LifeOnAFarm/RaveLearnDJTable/hardware/3d-prints/Switch Cover.STL

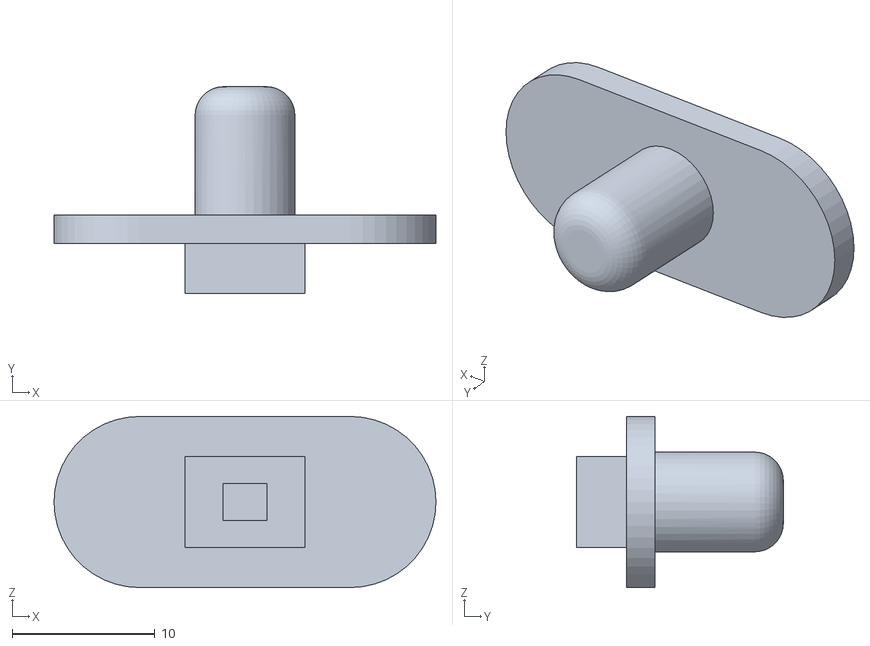
[picture p1: CAD file, 2026-10-12]
hardware/3d-prints/Switch Cover.STL
26.8 x 14.5 x 12.0
