LifeOnAFarm/RaveLearnDJTable/hardware/3d-prints/AS5600 Mount.STL

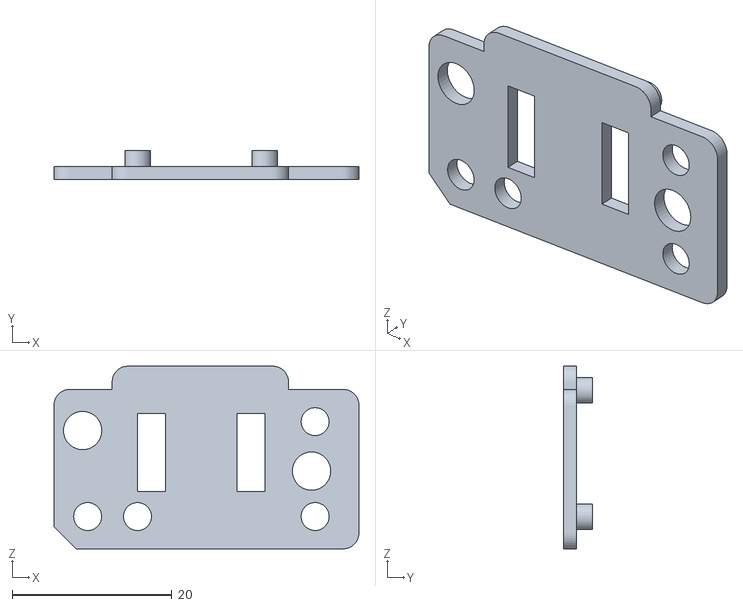
[picture p2: CAD file, 2026-10-10]
hardware/3d-prints/AS5600 Mount.STL
38.2 x 3.60 x 22.9
