LifeOnAFarm/RaveLearnDJTable/hardware/3d-prints/Mode Button.STL

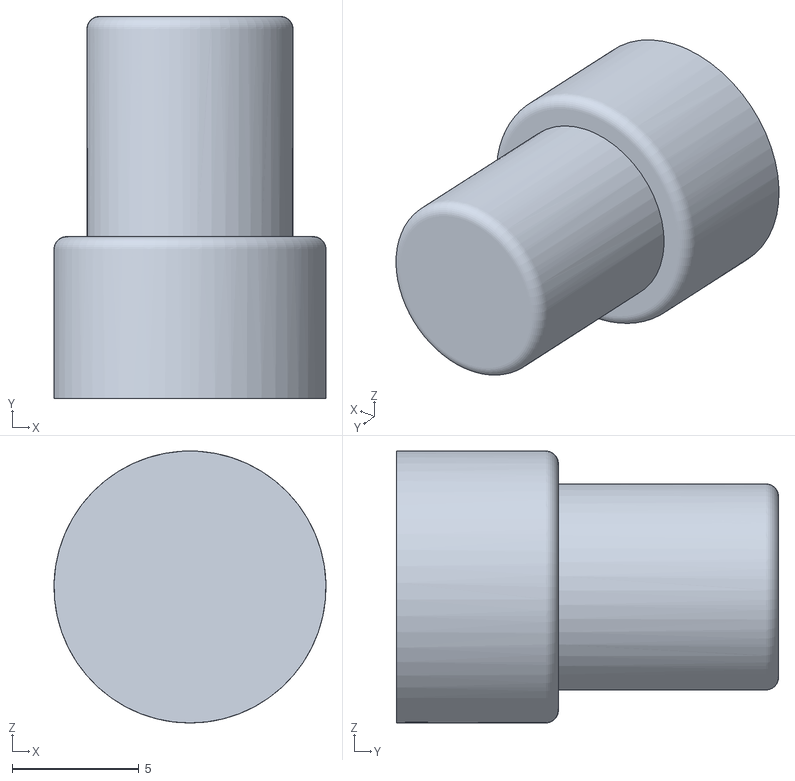
[picture p3: CAD file, 2026-10-10]
hardware/3d-prints/Mode Button.STL
10.8 x 15.1 x 10.8
