LifeOnAFarm/RaveLearnDJTable/hardware/3d-prints/Speaker Holder.STL

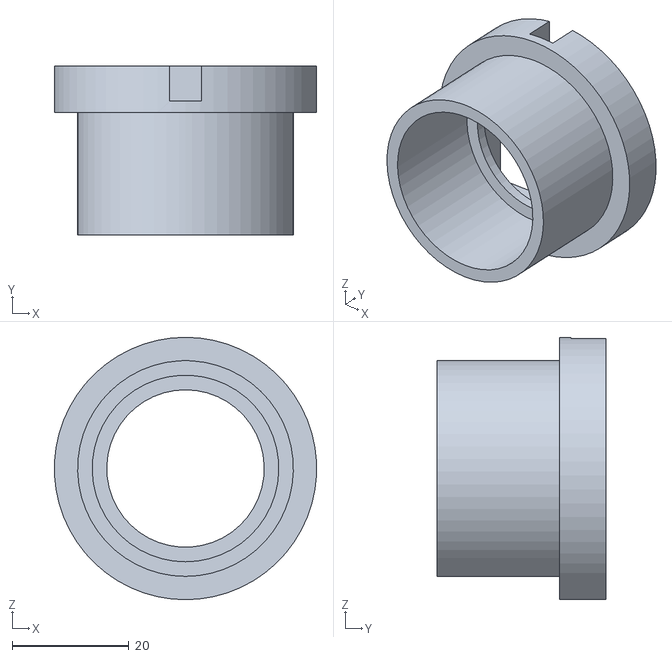
[picture p4: CAD file, 2026-10-10]
hardware/3d-prints/Speaker Holder.STL
44.9 x 29.0 x 45.0
