LifeOnAFarm/RaveLearnDJTable/hardware/3d-prints/Platter Mount.STL

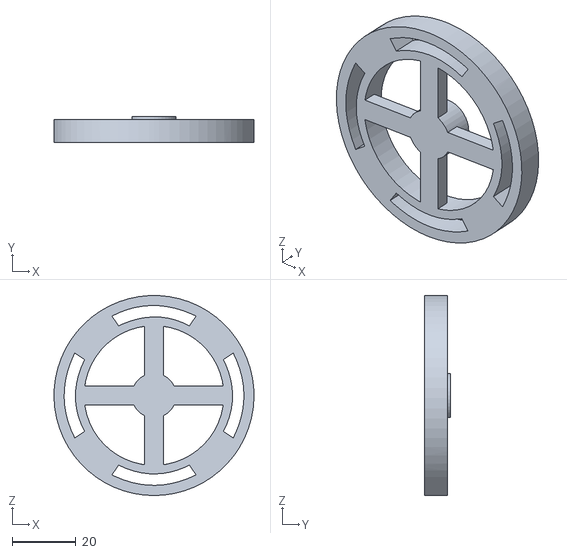
[picture p5: CAD file, 2026-10-10]
hardware/3d-prints/Platter Mount.STL
63.0 x 8.30 x 63.0
