LifeOnAFarm/RaveLearnDJTable/hardware/DJTable-schematic.pdf

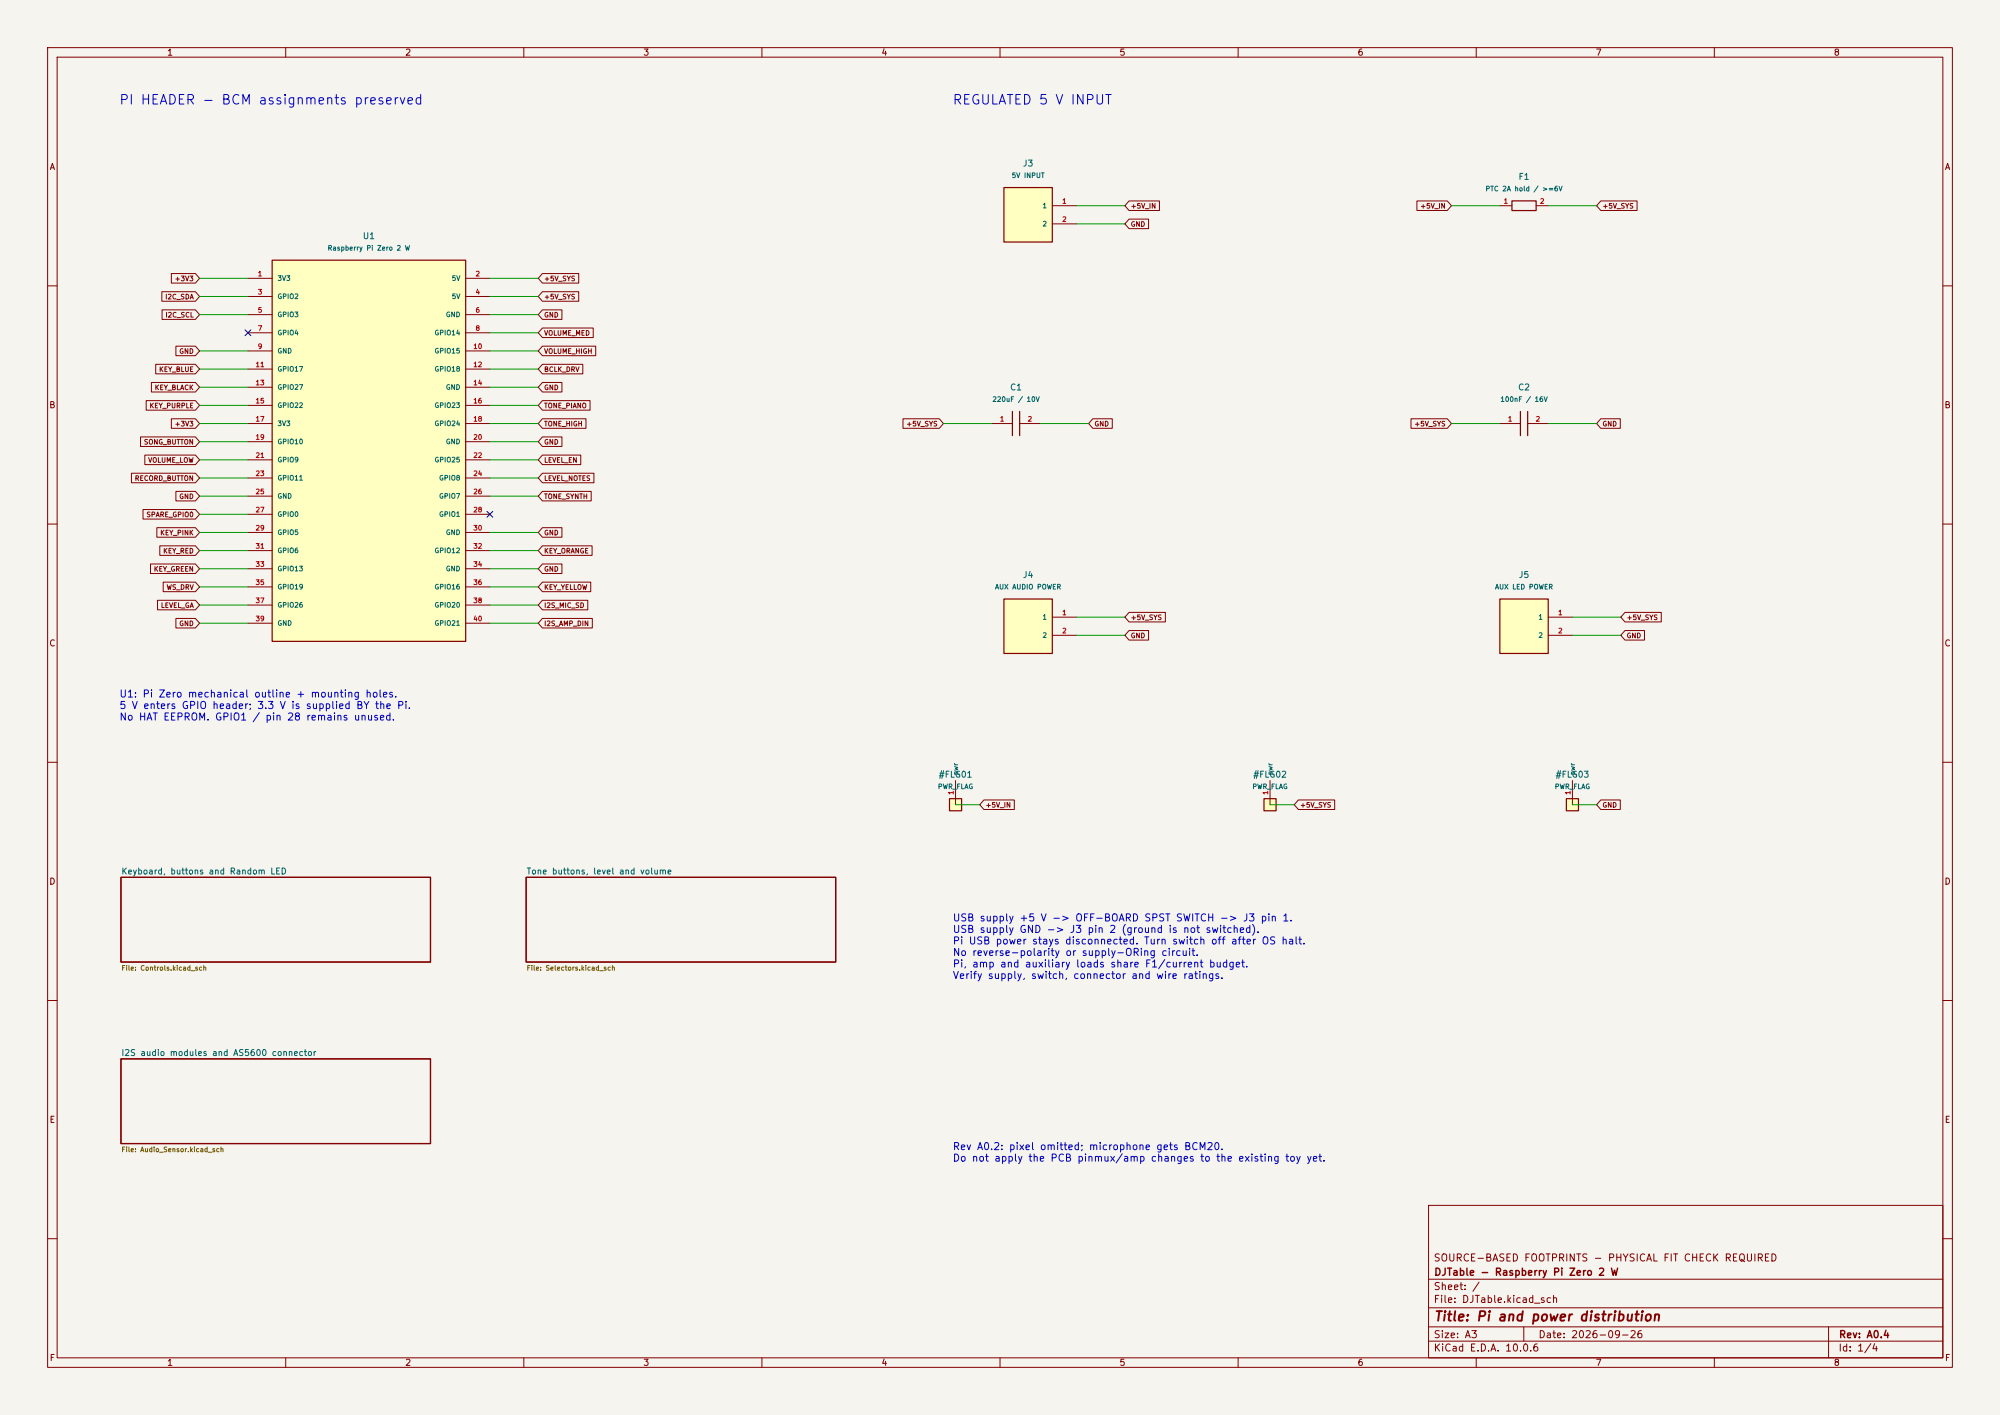
[picture p6: page 1]

PI HEADER - BCM assignments preserved

AUX LED POWER pwr 1 #FLG02

U1: Pi Zero mechanical outline + mounting holes.
5 V enters GPIO header; 3.3 V is supplied BY the Pi.
No HAT EEPROM. GPIO1 / pin 28 remains unused.

File: Selectors.kicad_sch Keyboard, buttons and Random LED

Tone buttons, level and volume

USB supply +5 V -> OFF-BOARD SPST SWITCH -> J3 pin 1.
USB supply GND -> J3 pin 2 (ground is not switched).
Pi USB power stays disconnected. Turn switch off after OS halt.
No reverse-polarity or supply-ORing circuit.
Pi, amp and auxiliary loads share F1/current budget.
Verify supply, switch, connector and wire ratings.

I2S audio modules and AS5600 connector File: Audio_Sensor.kicad_sch

Rev A0.2: pixel omitted; microphone gets BCM20.
Do not apply the PCB pinmux/amp changes to the existing toy yet.

SOURCE-BASED FOOTPRINTS - PHYSICAL FIT CHECK REQUIRED
DJTable - Raspberry Pi Zero 2 W
Sheet: /
File: DJTable.kicad_sch
Title: Pi and power distribution

Size: A3 | Rev: A0.4 | F Date: 2026-09-26
KiCad E.D.A. 10.0.6 | Id: 1/4

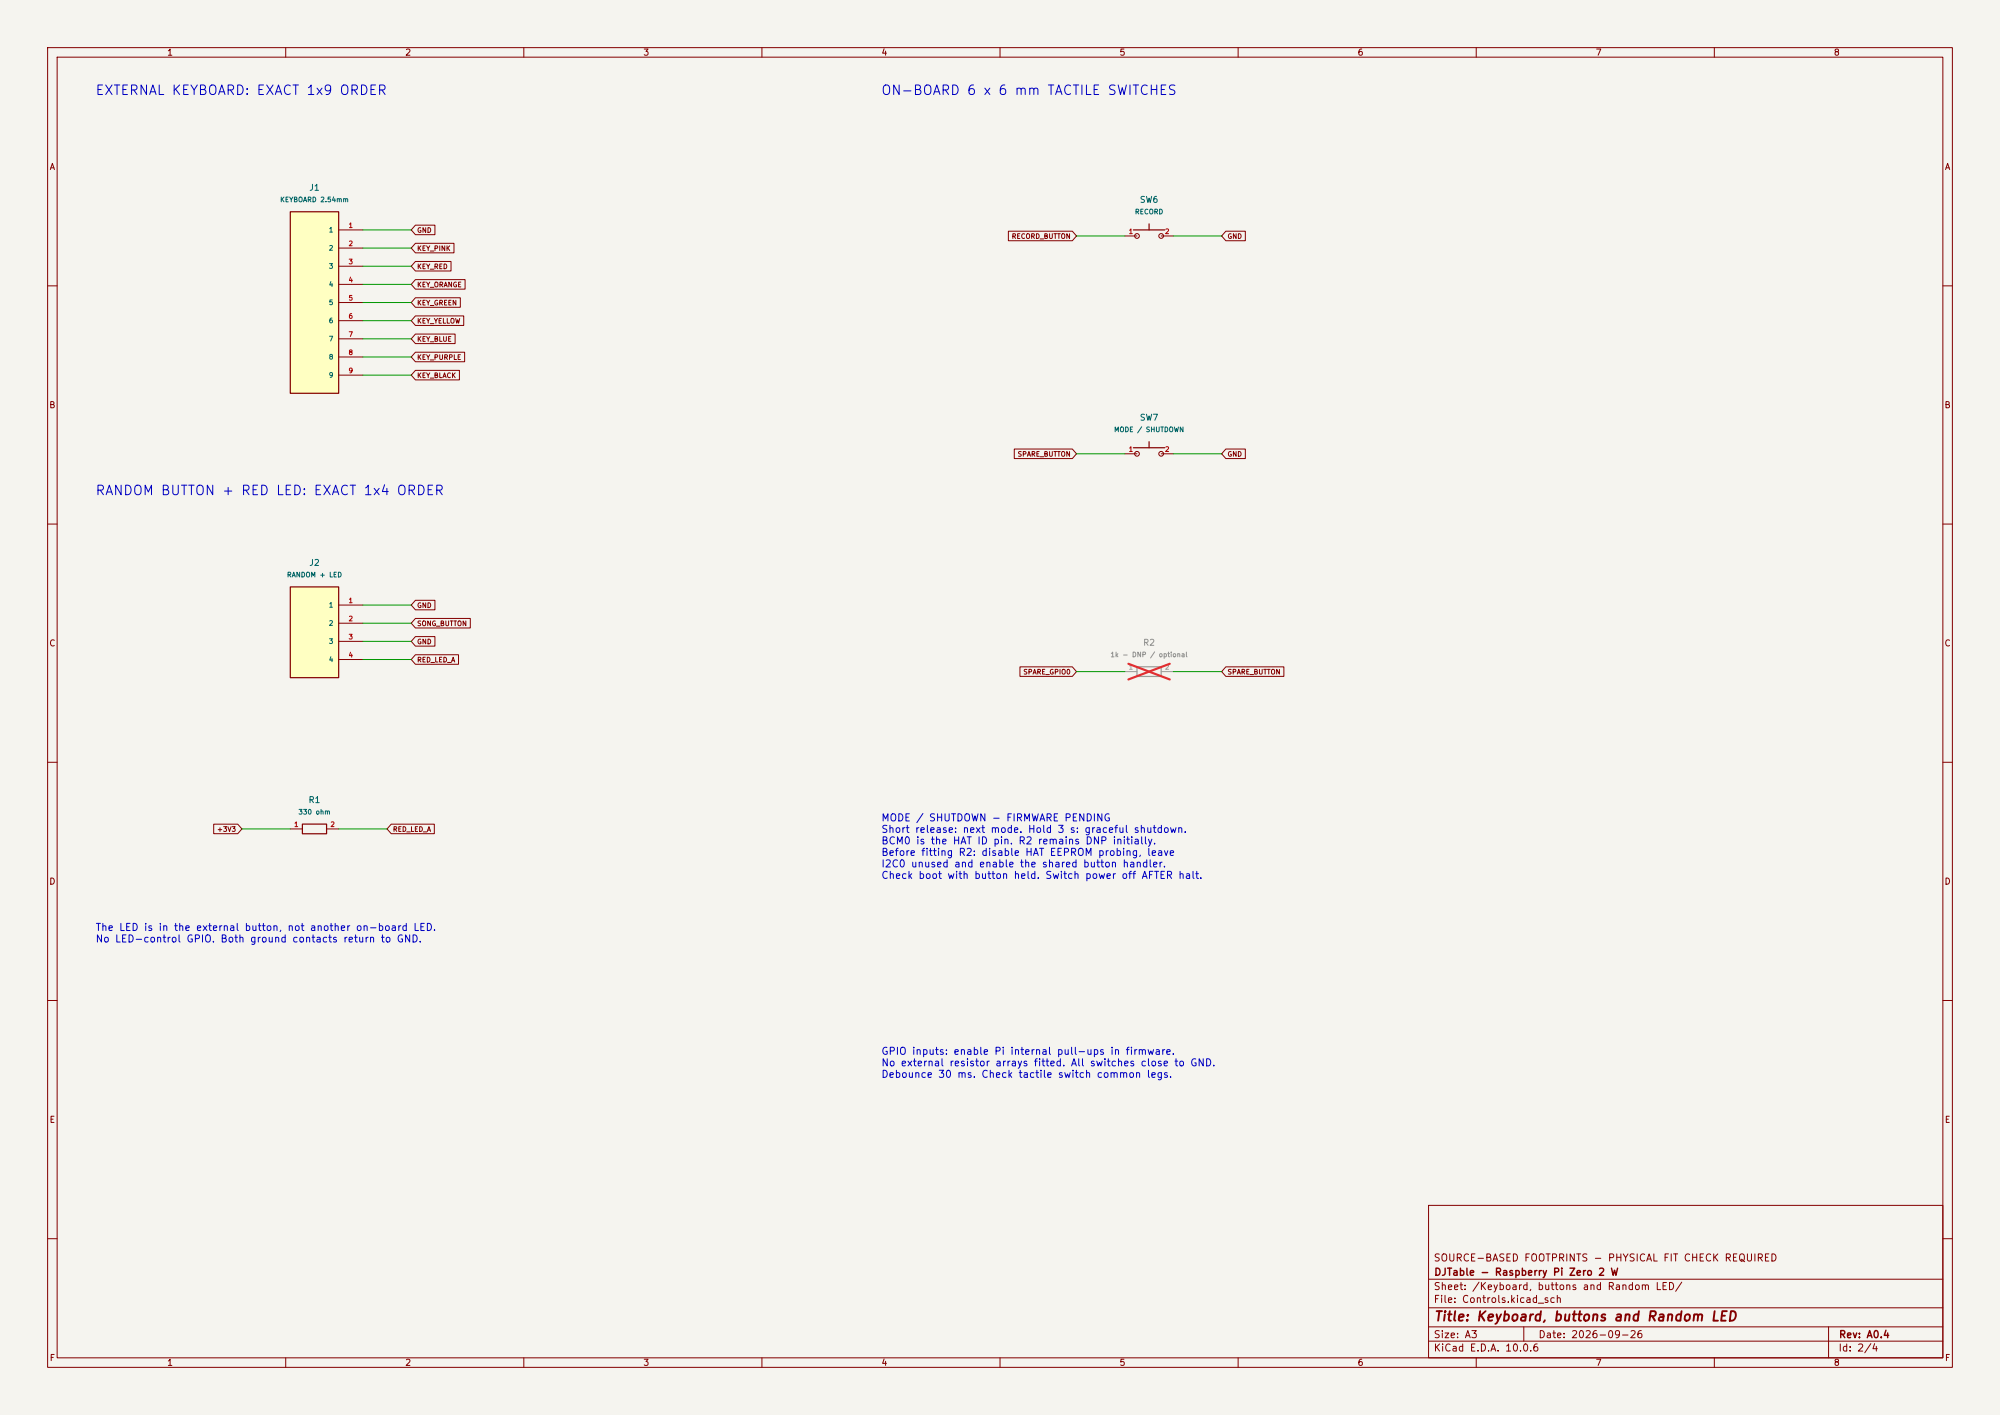
[picture p7: page 2]

EXTERNAL KEYBOARD: EXACT 1x9 ORDER

ON-BOARD 6 x 6 mm TACTILE SWITCHES

KEY_BLACK RANDOM BUTTON + RED LED: EXACT 1x4 ORDER

MODE / SHUTDOWN - FIRMWARE PENDING
Short release: next mode. Hold 3 s: graceful shutdown.
BCM0 is the HAT ID pin. R2 remains DNP initially.
Before fitting R2: disable HAT EEPROM probing, leave
I2C0 unused and enable the shared button handler.
Check boot with button held. Switch power off AFTER halt.

The LED is in the external button, not another on-board LED.
No LED-control GPIO. Both ground contacts return to GND.

GPIO inputs: enable Pi internal pull-ups in firmware.
No external resistor arrays fitted. All switches close to GND.
Debounce 30 ms. Check tactile switch common legs.

SOURCE-BASED FOOTPRINTS - PHYSICAL FIT CHECK REQUIRED
DJTable - Raspberry Pi Zero 2 W
Sheet: /Keyboard, buttons and Random LED/
File: Controls.kicad_sch
Title: Keyboard, buttons and Random LED

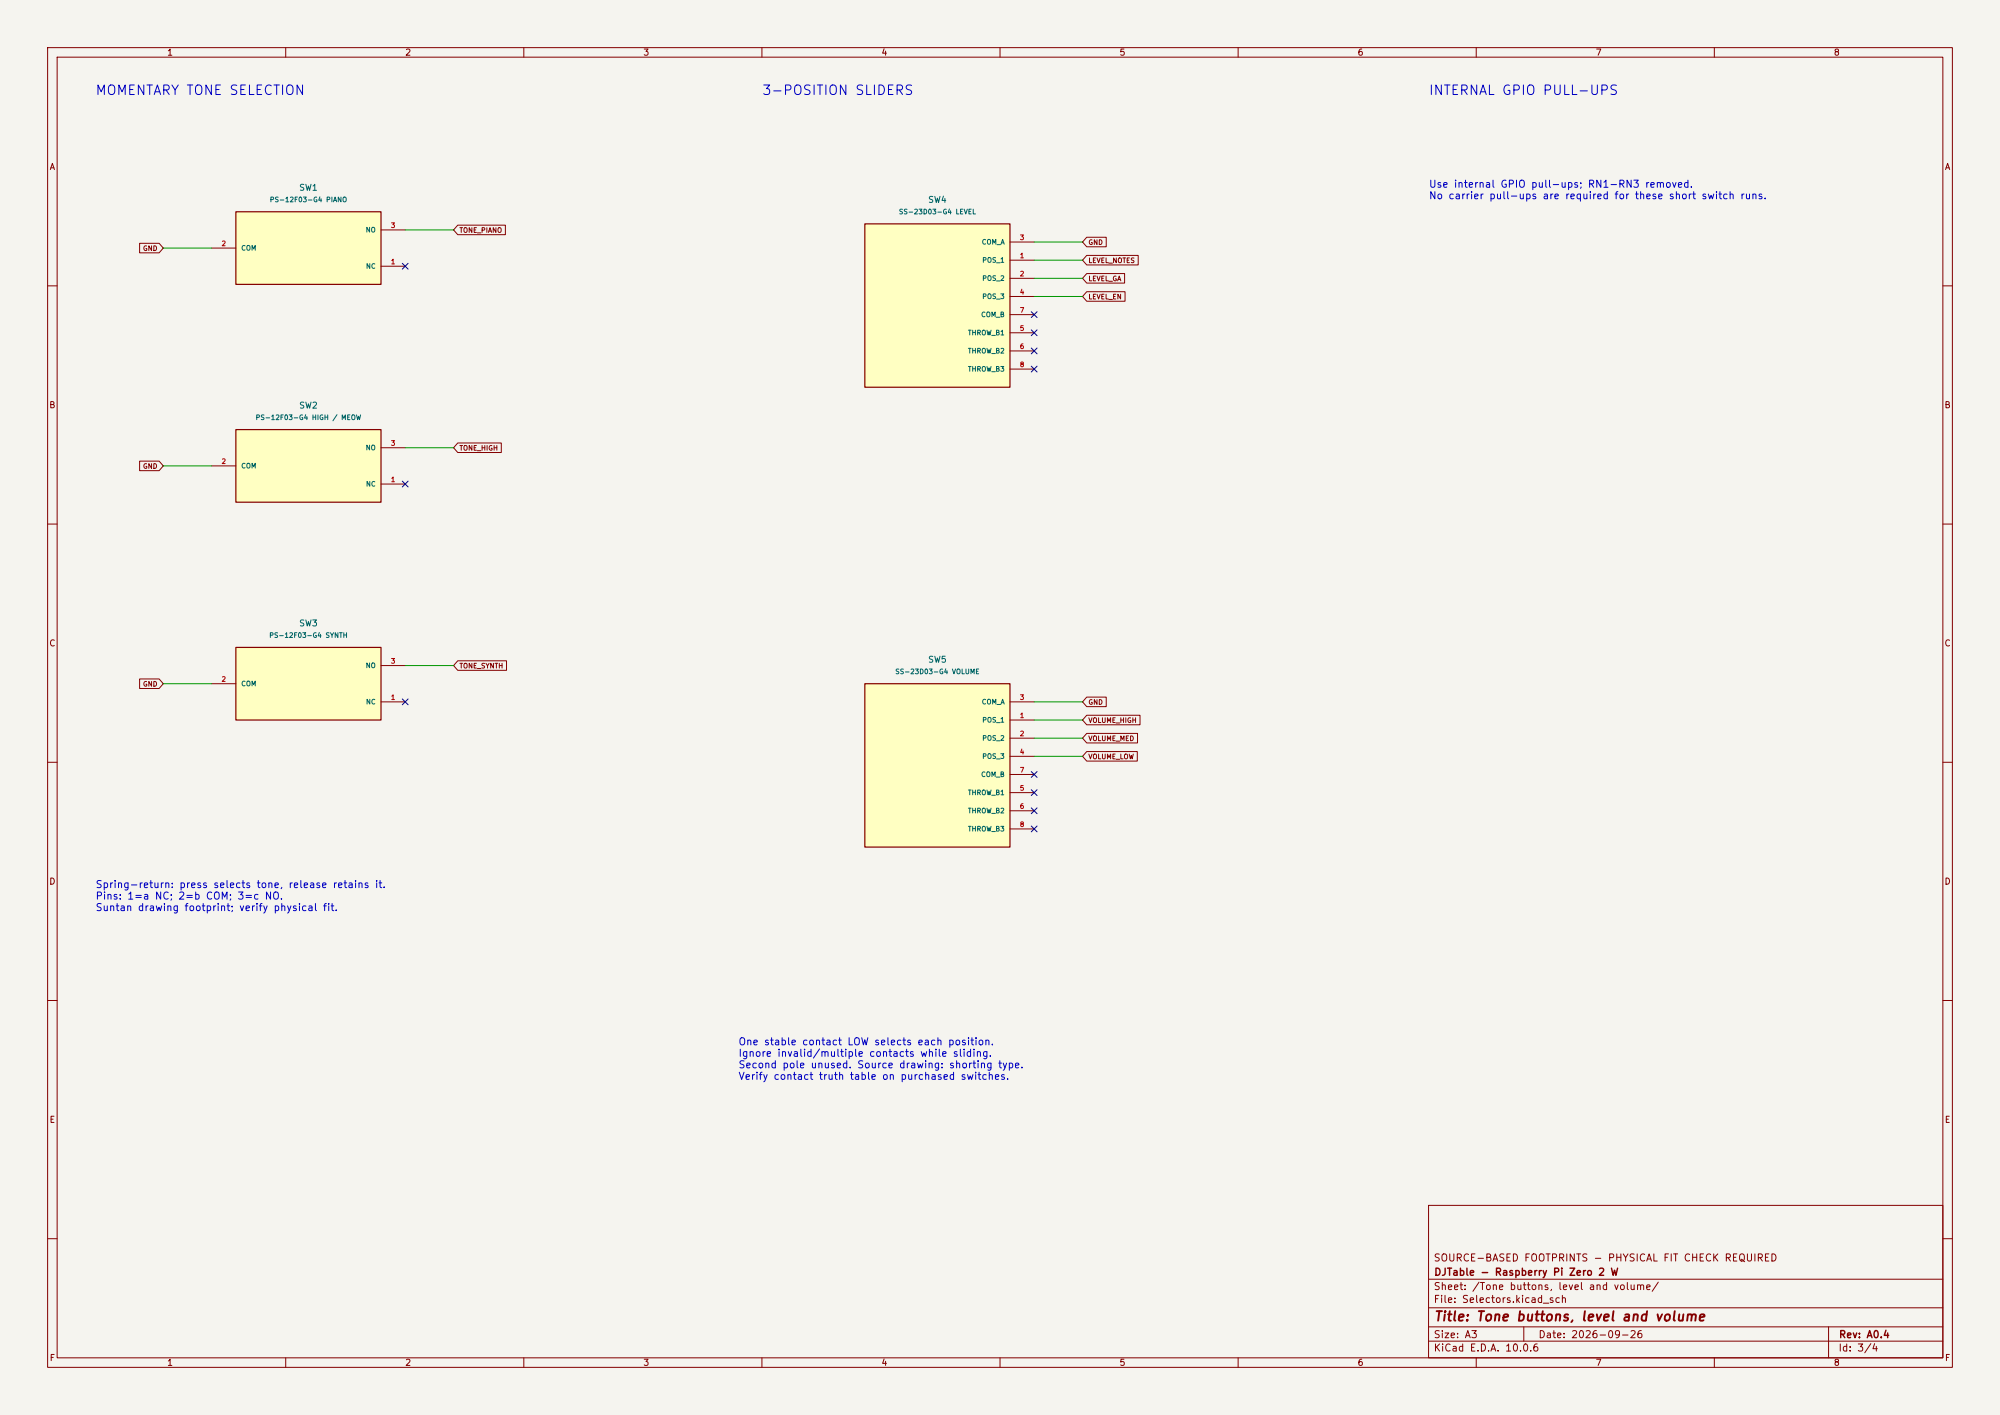
[picture p8: page 3]

Spring-return: press selects tone, release retains it.
Pins: 1=a NC; 2=b COM; 3=c NO.
Suntan drawing footprint; verify physical fit.

One stable contact LOW selects each position.
Ignore invalid/multiple contacts while sliding.
Second pole unused. Source drawing: shorting type.
Verify contact truth table on purchased switches.

SOURCE-BASED FOOTPRINTS - PHYSICAL FIT CHECK REQUIRED
DJTable - Raspberry Pi Zero 2 W
Sheet: /Tone buttons, level and volume/
File: Selectors.kicad_sch
Title: Tone buttons, level and volume

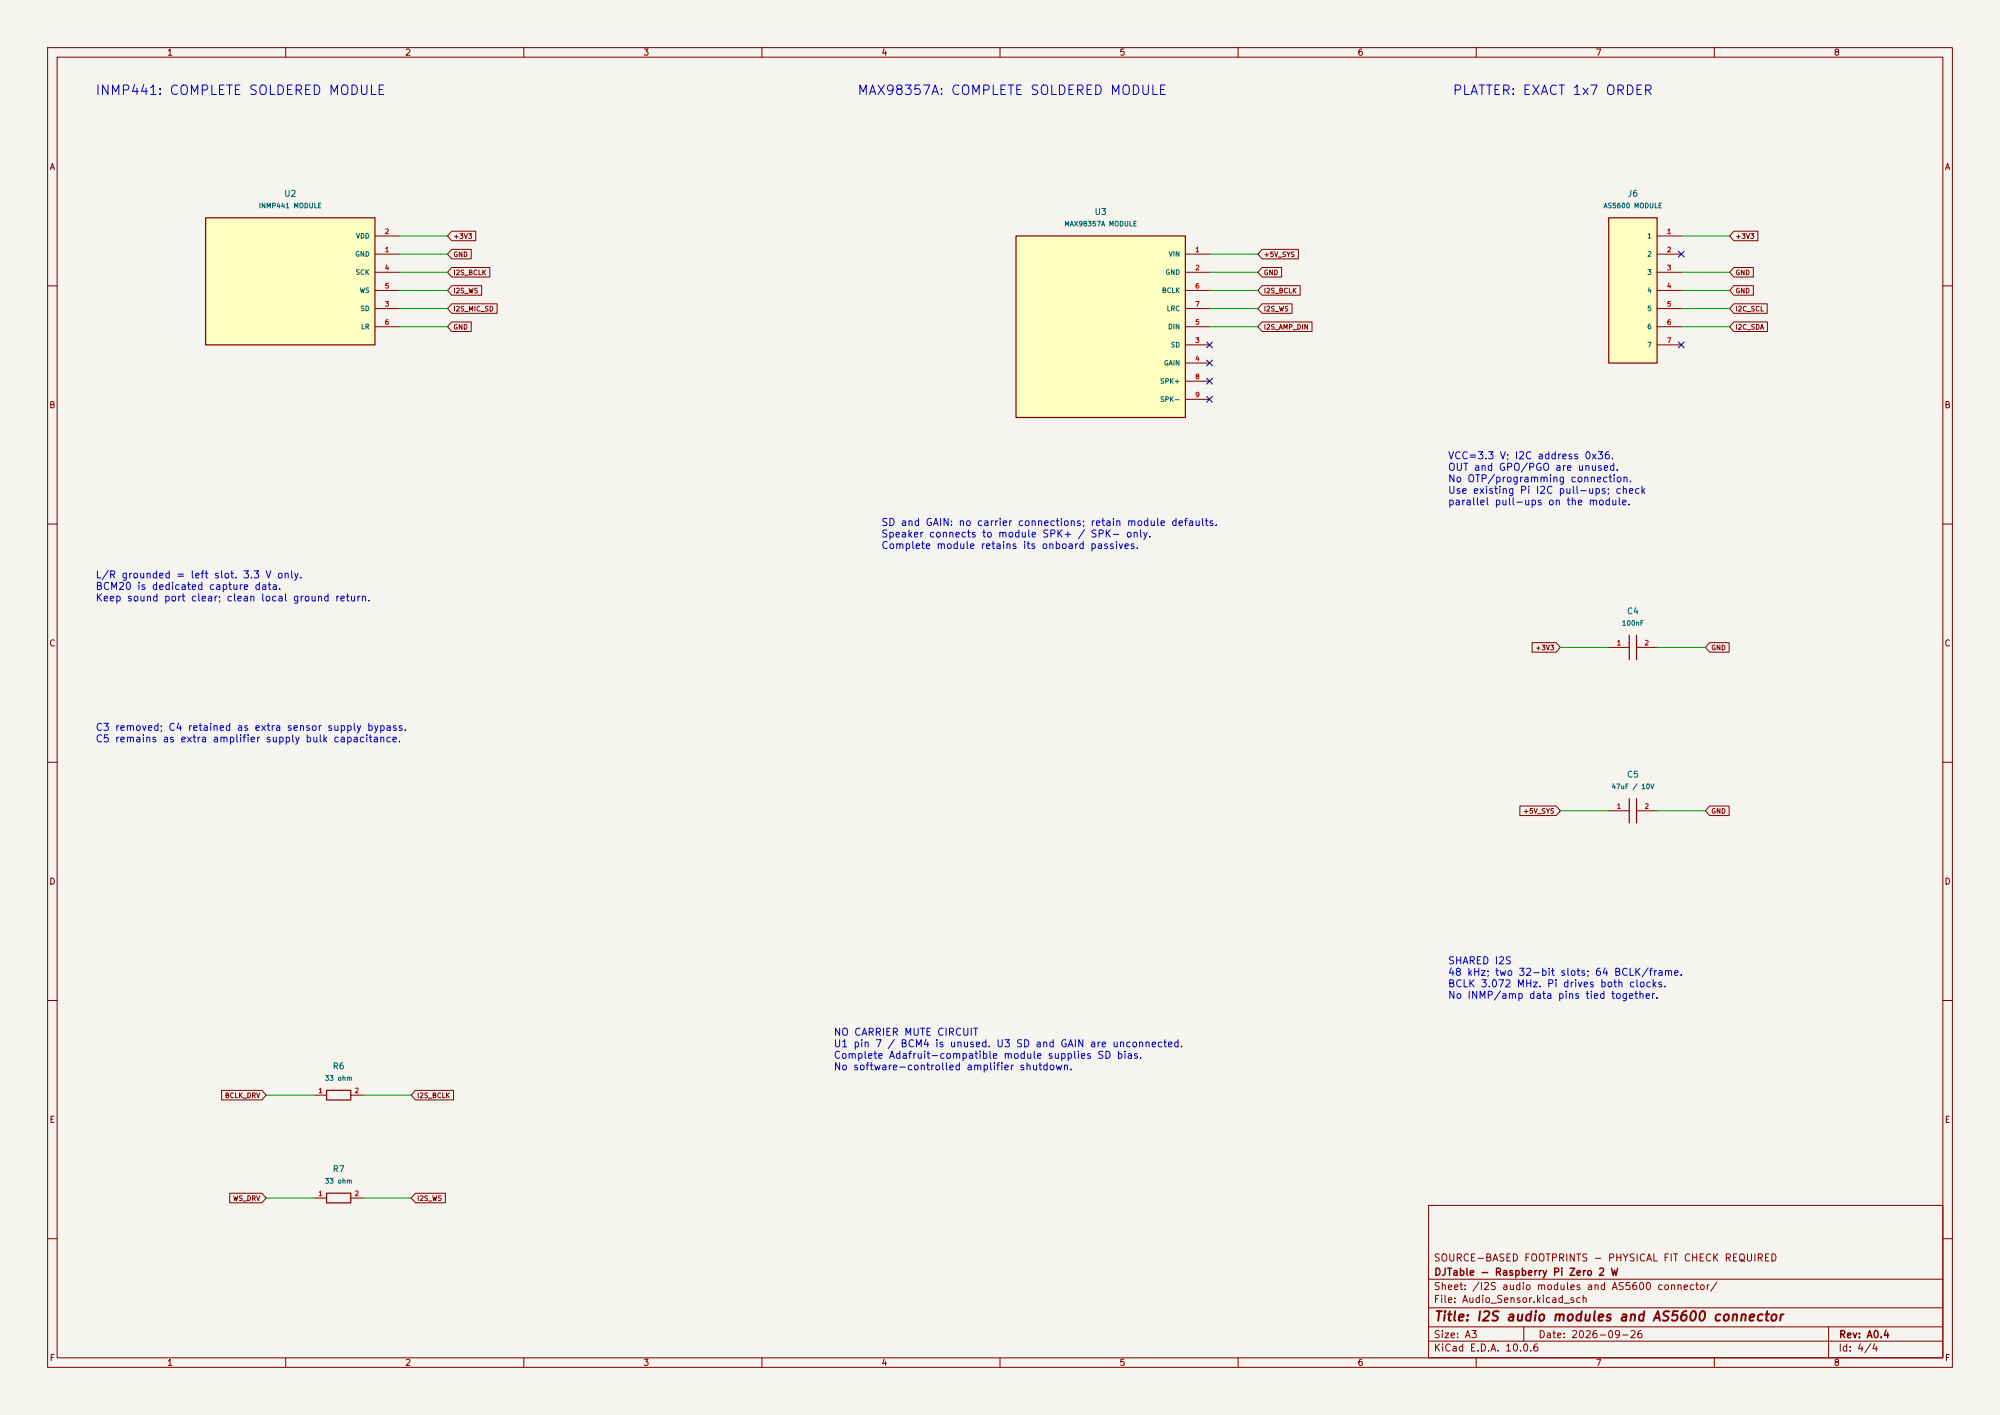
[picture p9: page 4]

VCC=3.3 V; I2C address 0x36.
OUT and GPO/PGO are unused.
No OTP/programming connection.
Use existing Pi I2C pull-ups; check
parallel pull-ups on the module.

SD and GAIN: no carrier connections; retain module defaults.
Speaker connects to module SPK+ / SPK- only.
Complete module retains its onboard passives.

L/R grounded = left slot. 3.3 V only.
BCM20 is dedicated capture data.
Keep sound port clear; clean local ground return.

C3 removed; C4 retained as extra sensor supply bypass.
C5 remains as extra amplifier supply bulk capacitance.

SHARED I2S
48 kHz; two 32-bit slots; 64 BCLK/frame.
BCLK 3.072 MHz. Pi drives both clocks.
No INMP/amp data pins tied together.

NO CARRIER MUTE CIRCUIT
U1 pin 7 / BCM4 is unused. U3 SD and GAIN are unconnected.
Complete Adafruit-compatible module supplies SD bias.
No software-controlled amplifier shutdown.

SOURCE-BASED FOOTPRINTS - PHYSICAL FIT CHECK REQUIRED
DJTable - Raspberry Pi Zero 2 W
Sheet: /I2S audio modules and AS5600 connector/
File: Audio_Sensor.kicad_sch
Title: I2S audio modules and AS5600 connector
