LifeOnAFarm/RaveLearnDJTable/hardware/kicad/DJTable.kicad_pcb

## KiCad design hardware/kicad/DJTable.kicad_pcb (2026-10-10)

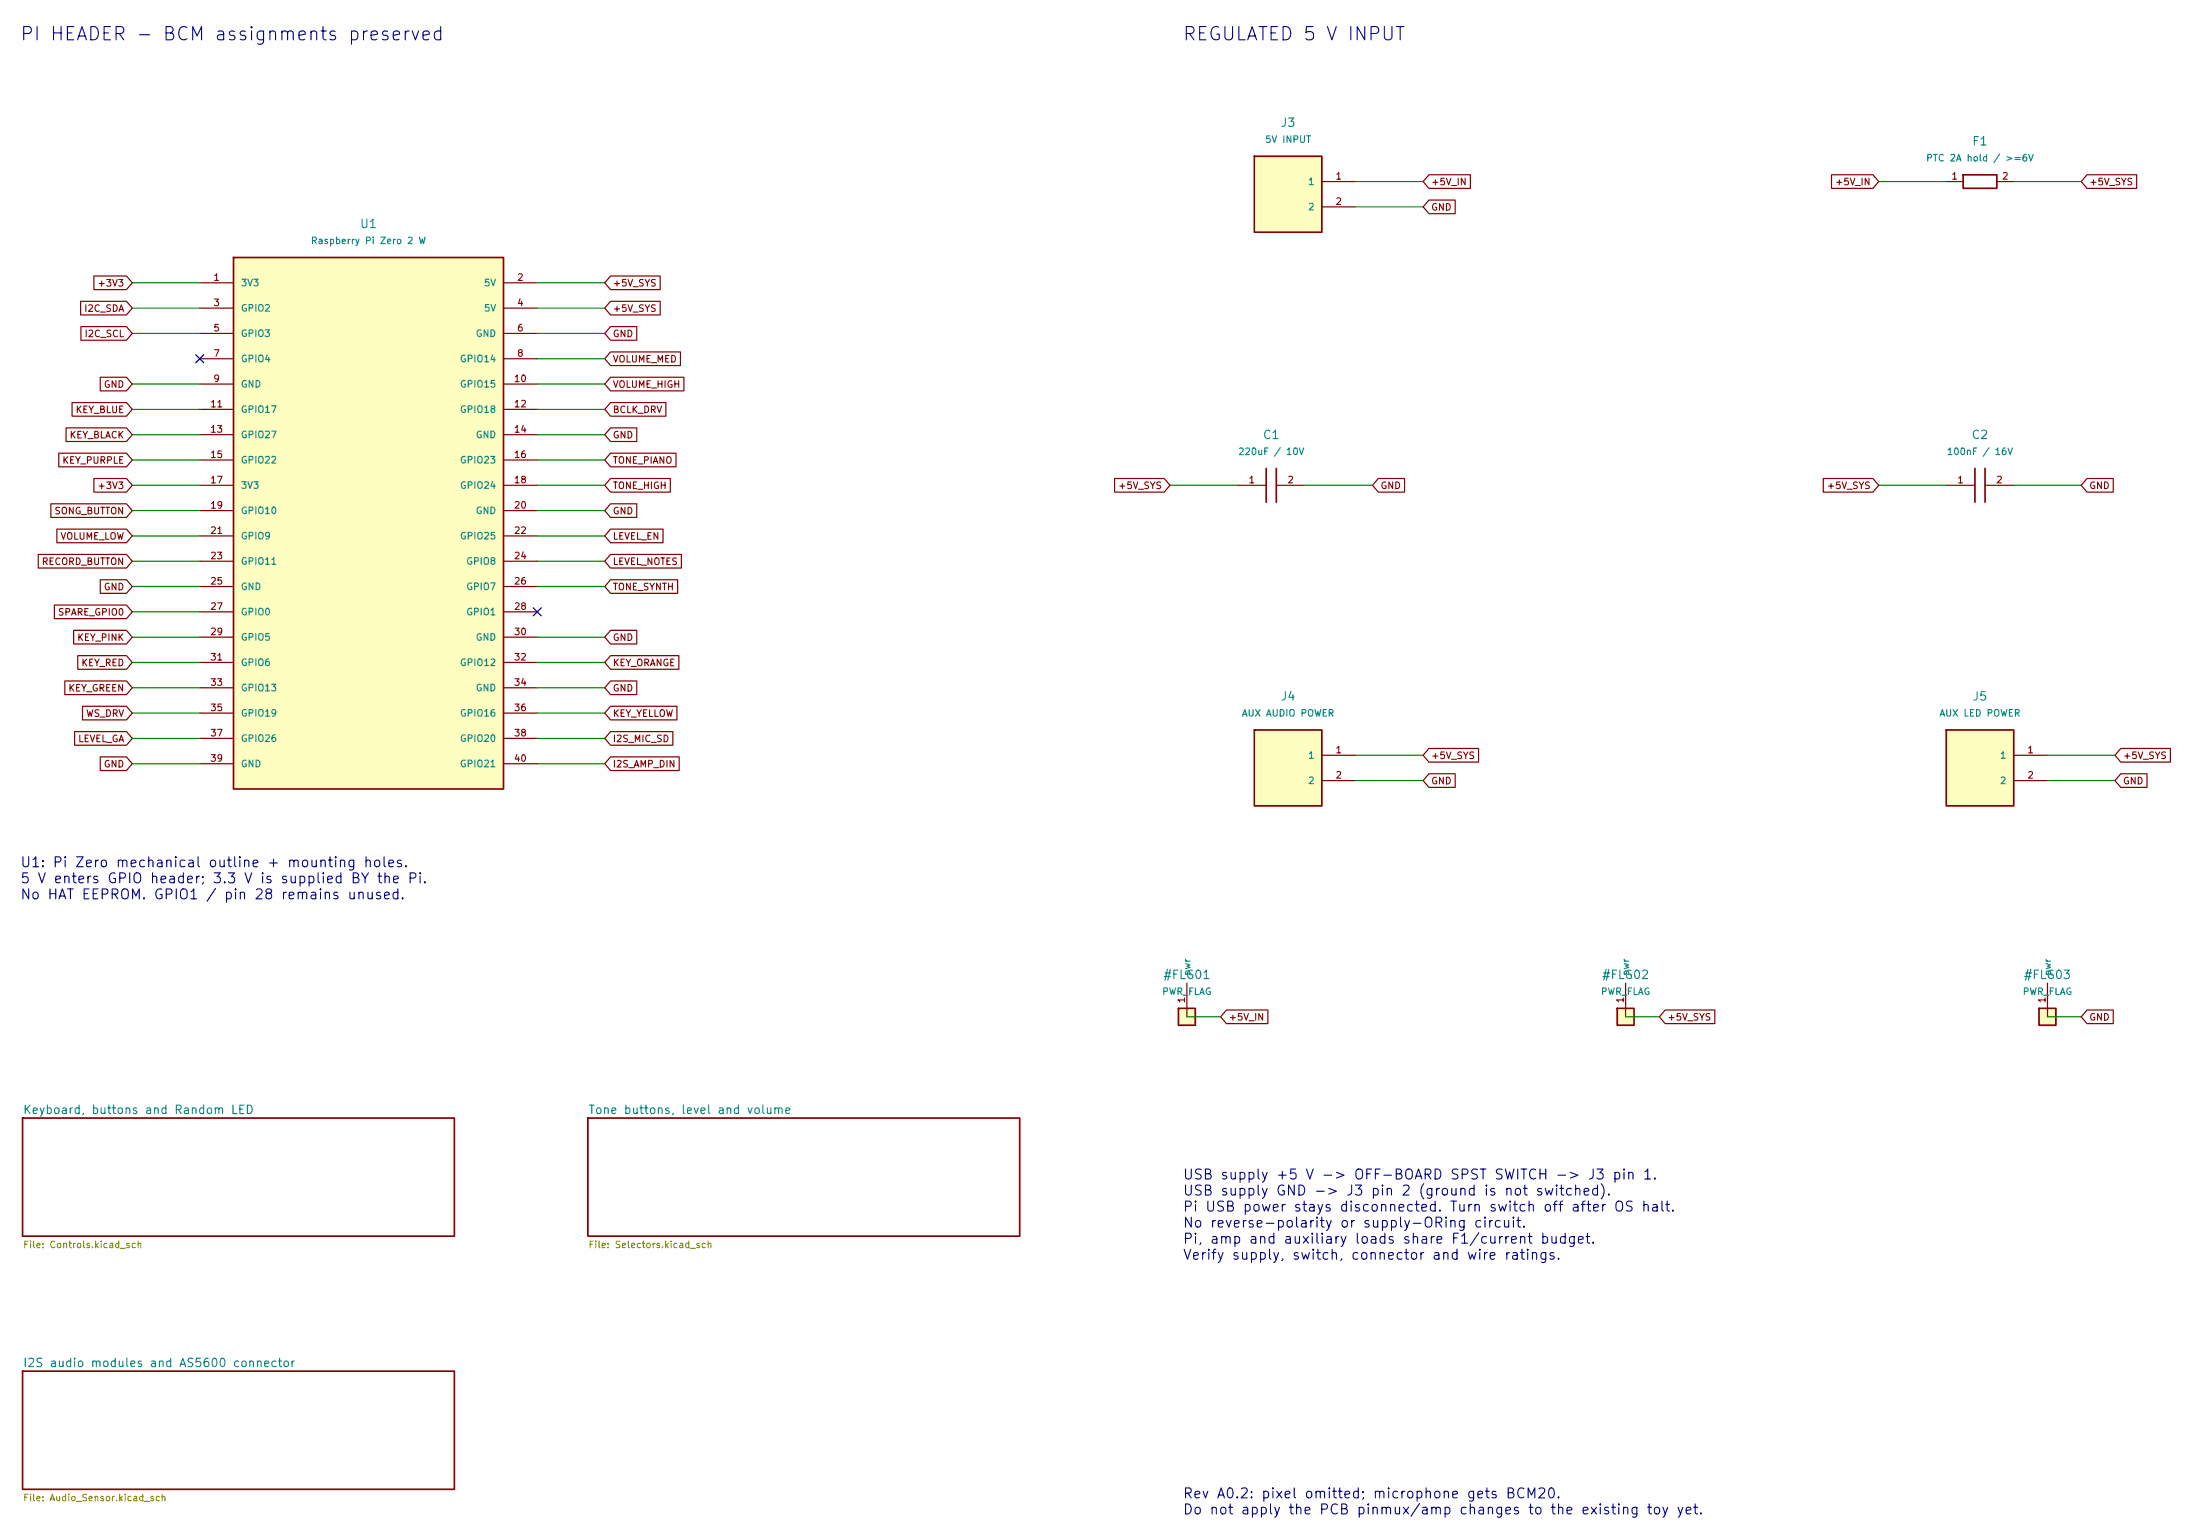
[picture p10: schematic DJTable.kicad_sch, Pi and power distribution]

Parts:
C1: 220uF / 10V; CP_Radial_D8.0mm_P3.50mm
C2: 100nF / 16V; C_1206_3216Metric_Pad1.33x1.80mm_HandSolder
F1: PTC 2A hold / >=6V; Fuse_1812_4532Metric
J3: 5V INPUT; PinHeader_1x02_P2.54mm_Vertical
J4: AUX AUDIO POWER; PinHeader_1x02_P2.54mm_Vertical
J5: AUX LED POWER; PinHeader_1x02_P2.54mm_Vertical
U1: Raspberry Pi Zero 2 W; Raspberry_Pi_Zero_Socketed_THT_FaceDown_MountingHoles

Connections:
+3V3: U1.1 (3V3), U1.17 (3V3); also elsewhere on the board
+5V_IN: F1.1, J3.1
+5V_SYS: C1.1, C2.1, F1.2, J4.1, J5.1, U1.2 (5V), U1.4 (5V); also elsewhere on the board
BCLK_DRV: U1.12 (GPIO18); also elsewhere on the board
GND: C1.2, C2.2, J3.2, J4.2, J5.2, U1.6 (GND), U1.9 (GND), U1.14 (GND), U1.20 (GND), U1.25 (GND), U1.30 (GND), U1.34 (GND), U1.39 (GND); also elsewhere on the board
I2C_SCL: U1.5 (GPIO3); also elsewhere on the board
I2C_SDA: U1.3 (GPIO2); also elsewhere on the board
I2S_AMP_DIN: U1.40 (GPIO21); also elsewhere on the board
I2S_MIC_SD: U1.38 (GPIO20); also elsewhere on the board
KEY_BLACK: U1.13 (GPIO27); also elsewhere on the board
KEY_BLUE: U1.11 (GPIO17); also elsewhere on the board
KEY_GREEN: U1.33 (GPIO13); also elsewhere on the board
KEY_ORANGE: U1.32 (GPIO12); also elsewhere on the board
KEY_PINK: U1.29 (GPIO5); also elsewhere on the board
KEY_PURPLE: U1.15 (GPIO22); also elsewhere on the board
KEY_RED: U1.31 (GPIO6); also elsewhere on the board
KEY_YELLOW: U1.36 (GPIO16); also elsewhere on the board
LEVEL_EN: U1.22 (GPIO25); also elsewhere on the board
LEVEL_GA: U1.37 (GPIO26); also elsewhere on the board
LEVEL_NOTES: U1.24 (GPIO8); also elsewhere on the board
RECORD_BUTTON: U1.23 (GPIO11); also elsewhere on the board
SONG_BUTTON: U1.19 (GPIO10); also elsewhere on the board
SPARE_GPIO0: U1.27 (GPIO0); also elsewhere on the board
TONE_HIGH: U1.18 (GPIO24); also elsewhere on the board
TONE_PIANO: U1.16 (GPIO23); also elsewhere on the board
TONE_SYNTH: U1.26 (GPIO7); also elsewhere on the board
VOLUME_HIGH: U1.10 (GPIO15); also elsewhere on the board
VOLUME_LOW: U1.21 (GPIO9); also elsewhere on the board
VOLUME_MED: U1.8 (GPIO14); also elsewhere on the board
WS_DRV: U1.35 (GPIO19); also elsewhere on the board

Notes on the sheet:
PI HEADER - BCM assignments preserved
REGULATED 5 V INPUT
Rev A0.2: pixel omitted; microphone gets BCM20. Do not apply the PCB pinmux/amp changes to the existing toy yet.
USB supply +5 V -> OFF-BOARD SPST SWITCH -> J3 pin 1. USB supply GND -> J3 pin 2 (ground is not switched). Pi USB power stays disconnected. Turn switch off after OS halt. No reverse-polarity or supply-ORing circuit. Pi, amp and auxiliary loads share F1/current budget. Verify supply, switch, connect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
U1: Pi Zero mechanical outline + mounting holes. 5 V enters GPIO header; 3.3 V is supplied BY the Pi. No HAT EEPROM. GPIO1 / pin 28 remains unused.

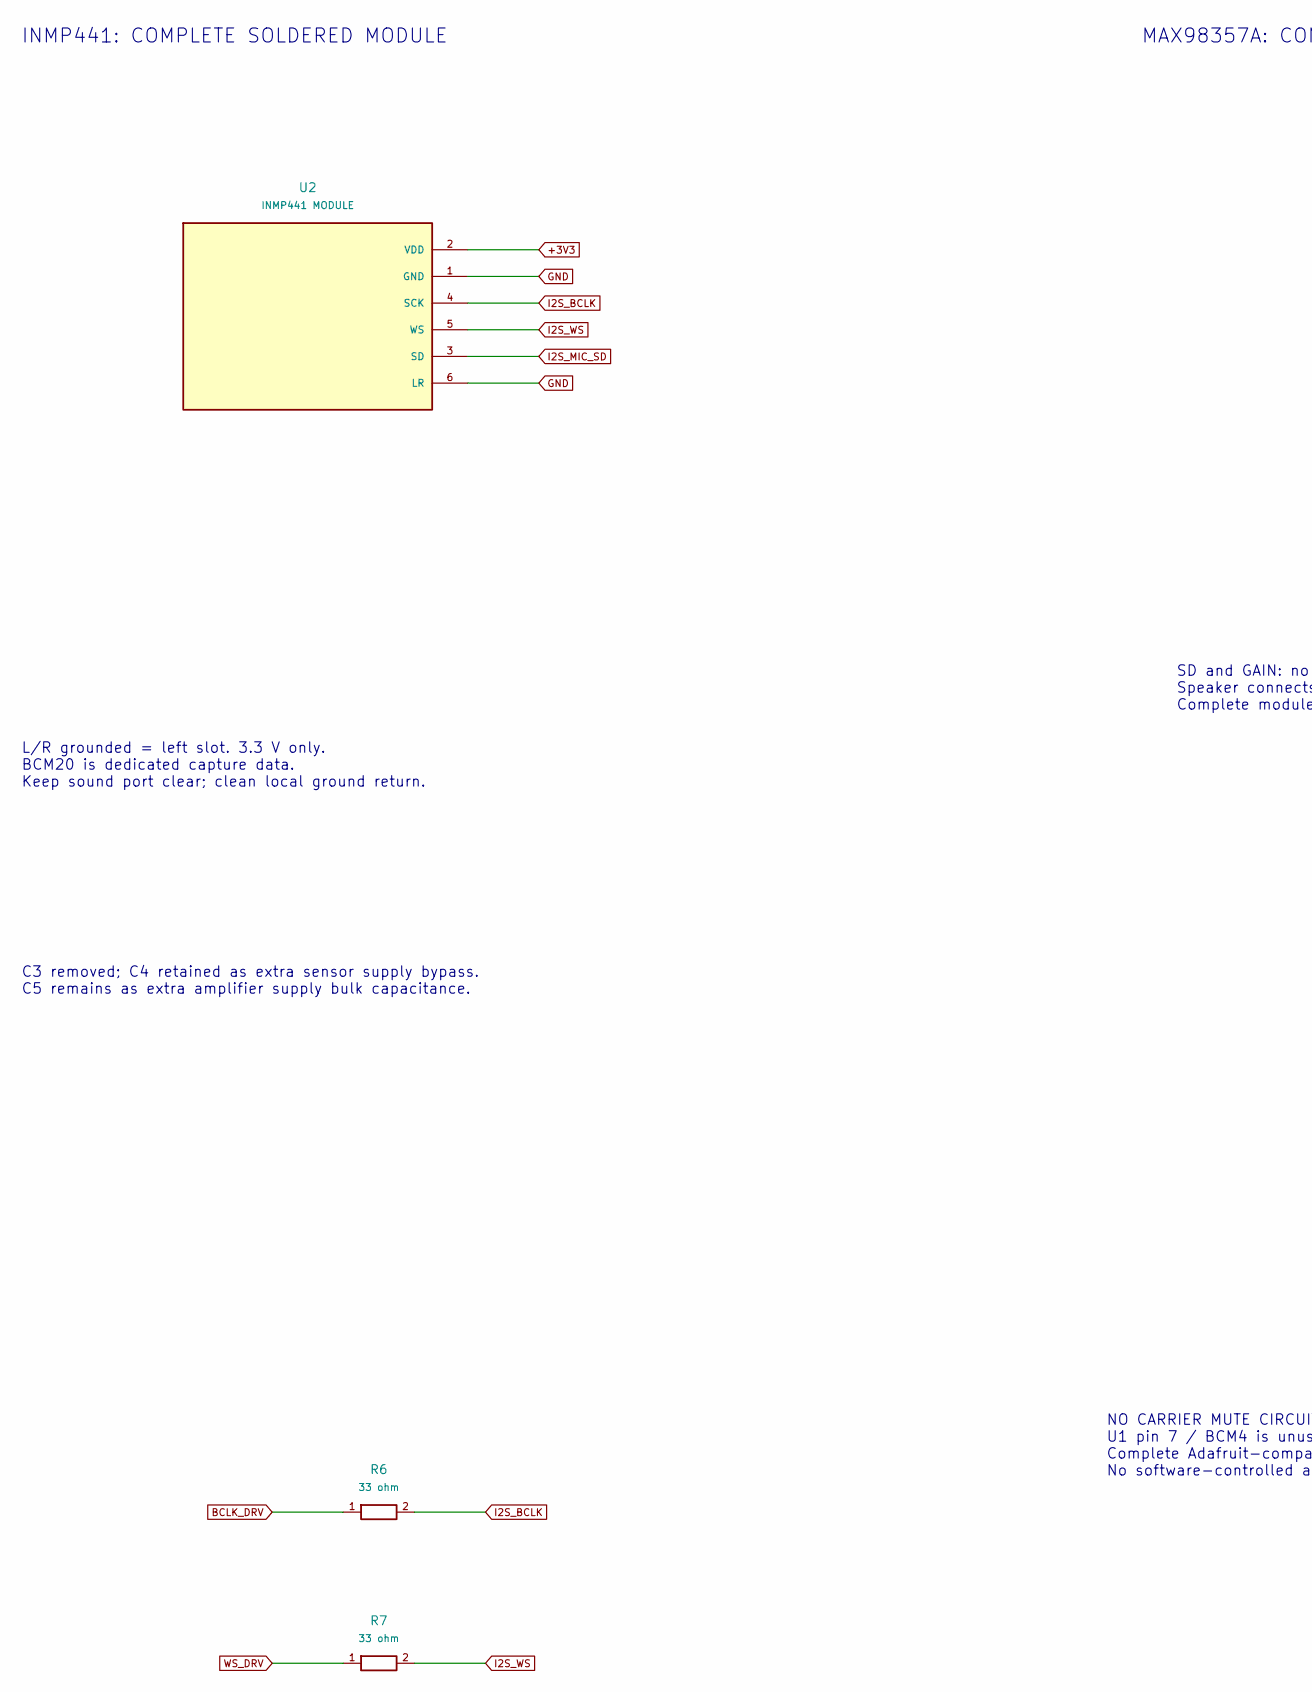
[picture p11: schematic Audio_Sensor.kicad_sch, I2S audio modules and AS5600 connector, part in row 1, column 1]

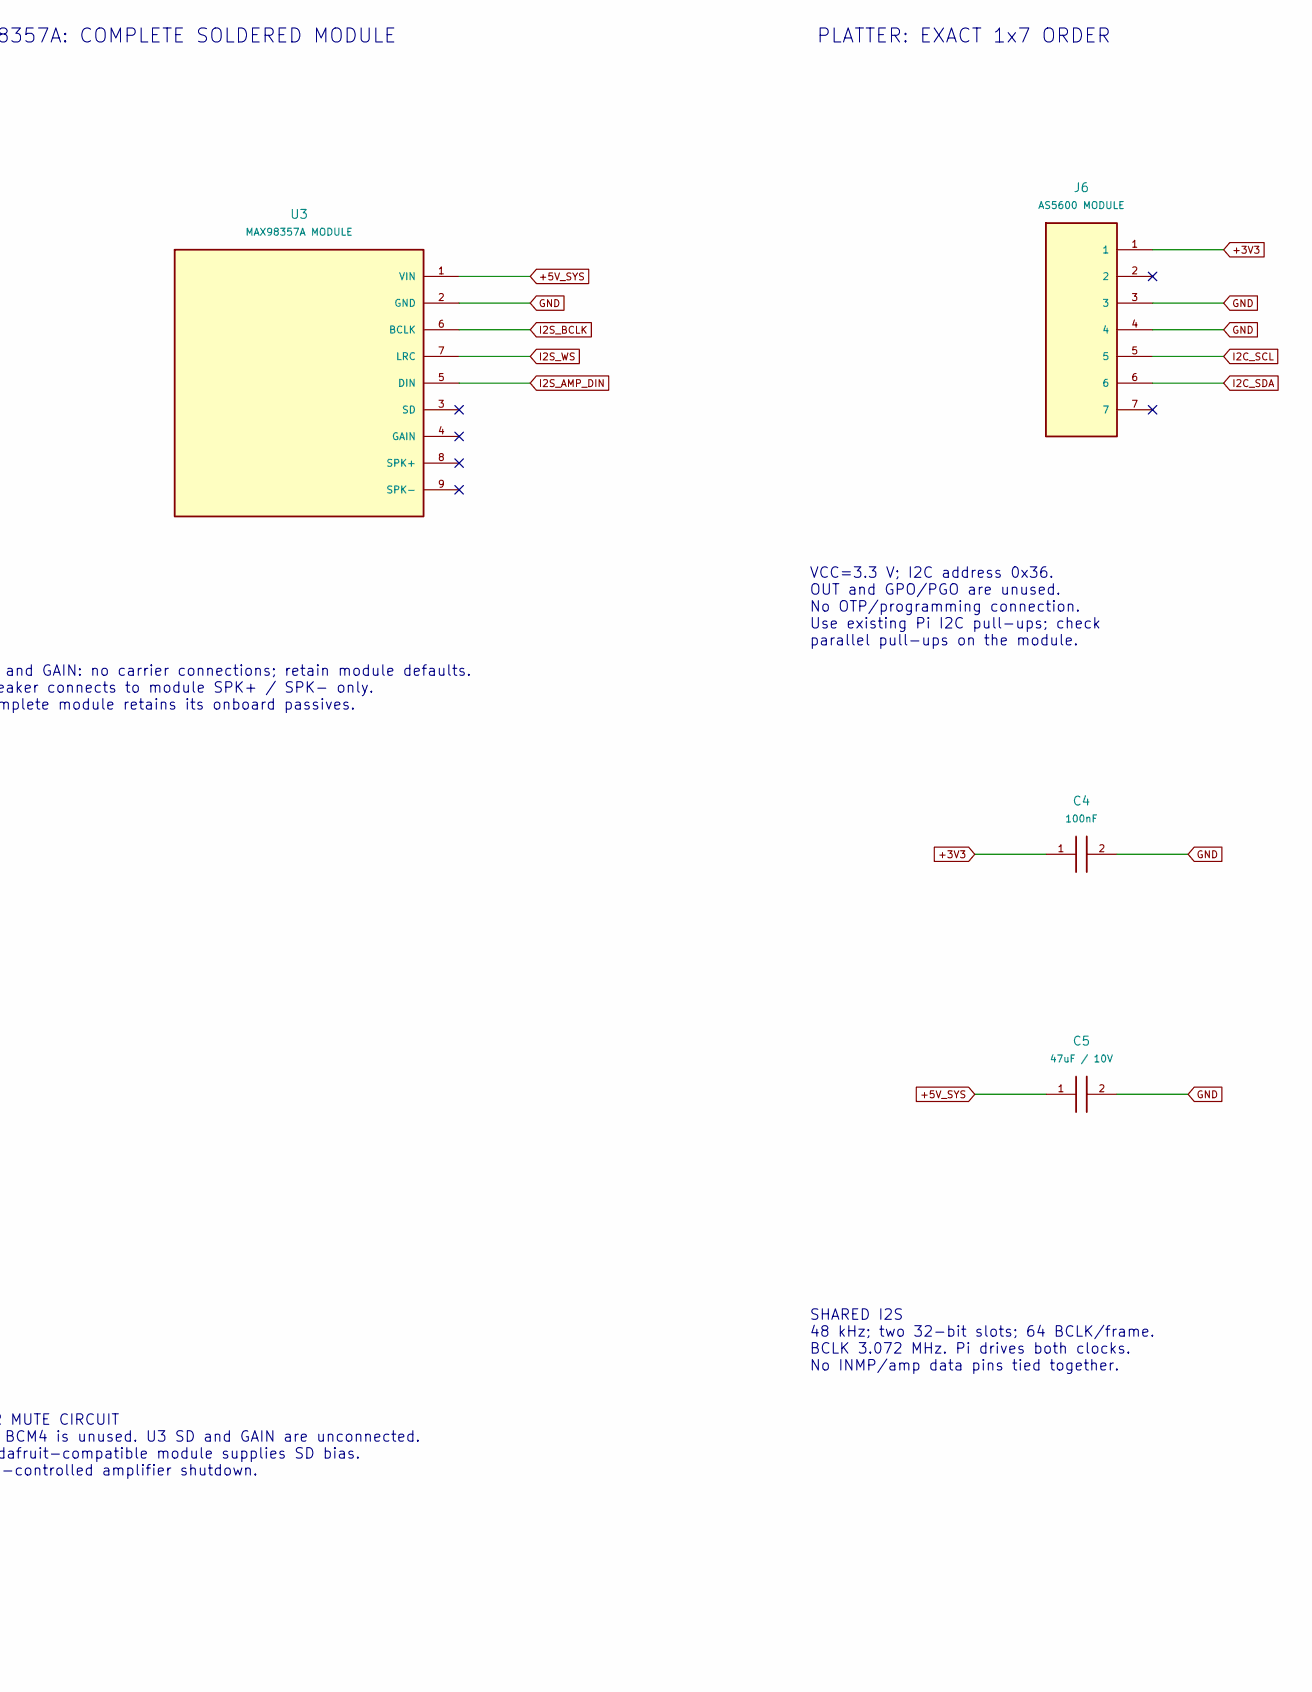
[picture p12: schematic Audio_Sensor.kicad_sch, I2S audio modules and AS5600 connector, part in row 1, column 2]

Parts:
C4: 100nF; C_1206_3216Metric_Pad1.33x1.80mm_HandSolder
C5: 47uF / 10V; CP_Radial_D5.0mm_P2.00mm
J6: AS5600 MODULE; PinHeader_1x07_P2.54mm_Vertical
R6, R7: 33 ohm; R_1206_3216Metric_Pad1.30x1.75mm_HandSolder
U2: INMP441 MODULE; INMP441_Round_Module_2x3_P2.54_Row7.62
U3: MAX98357A MODULE; MAX98357_Adafruit_Module

Connections:
+3V3: C4.1, J6.1, U2.2 (VDD); also elsewhere on the board
+5V_SYS: C5.1, U3.1 (VIN); also elsewhere on the board
BCLK_DRV: R6.1; also elsewhere on the board
GND: C4.2, C5.2, J6.3, J6.4, U2.1 (GND), U2.6 (LR), U3.2 (GND); also elsewhere on the board
I2C_SCL: J6.5; also elsewhere on the board
I2C_SDA: J6.6; also elsewhere on the board
I2S_AMP_DIN: U3.5 (DIN); also elsewhere on the board
I2S_BCLK: R6.2, U2.4 (SCK), U3.6 (BCLK)
I2S_MIC_SD: U2.3 (SD); also elsewhere on the board
I2S_WS: R7.2, U2.5 (WS), U3.7 (LRC)
WS_DRV: R7.1; also elsewhere on the board

Notes on the sheet:
PLATTER: EXACT 1x7 ORDER
SD and GAIN: no carrier connections; retain module defaults. Speaker connects to module SPK+ / SPK- only. Complete module retains its onboard passives.
SHARED I2S 48 kHz; two 32-bit slots; 64 BCLK/frame. BCLK 3.072 MHz. Pi drives both clocks. No INMP/amp data pins tied together.
NO CARRIER MUTE CIRCUIT U1 pin 7 / BCM4 is unused. U3 SD and GAIN are unconnected. Complete Adafruit-compatible module supplies SD bias. No software-controlled amplifier shutdown.
INMP441: COMPLETE SOLDERED MODULE
VCC=3.3 V; I2C address 0x36. OUT and GPO/PGO are unused. No OTP/programming connection. Use existing Pi I2C pull-ups; check parallel pull-ups on the module.
MAX98357A: COMPLETE SOLDERED MODULE
L/R grounded = left slot. 3.3 V only. BCM20 is dedicated capture data. Keep sound port clear; clean local ground return.
C3 removed; C4 retained as extra sensor supply bypass. C5 remains as extra amplifier supply bulk capacitance.

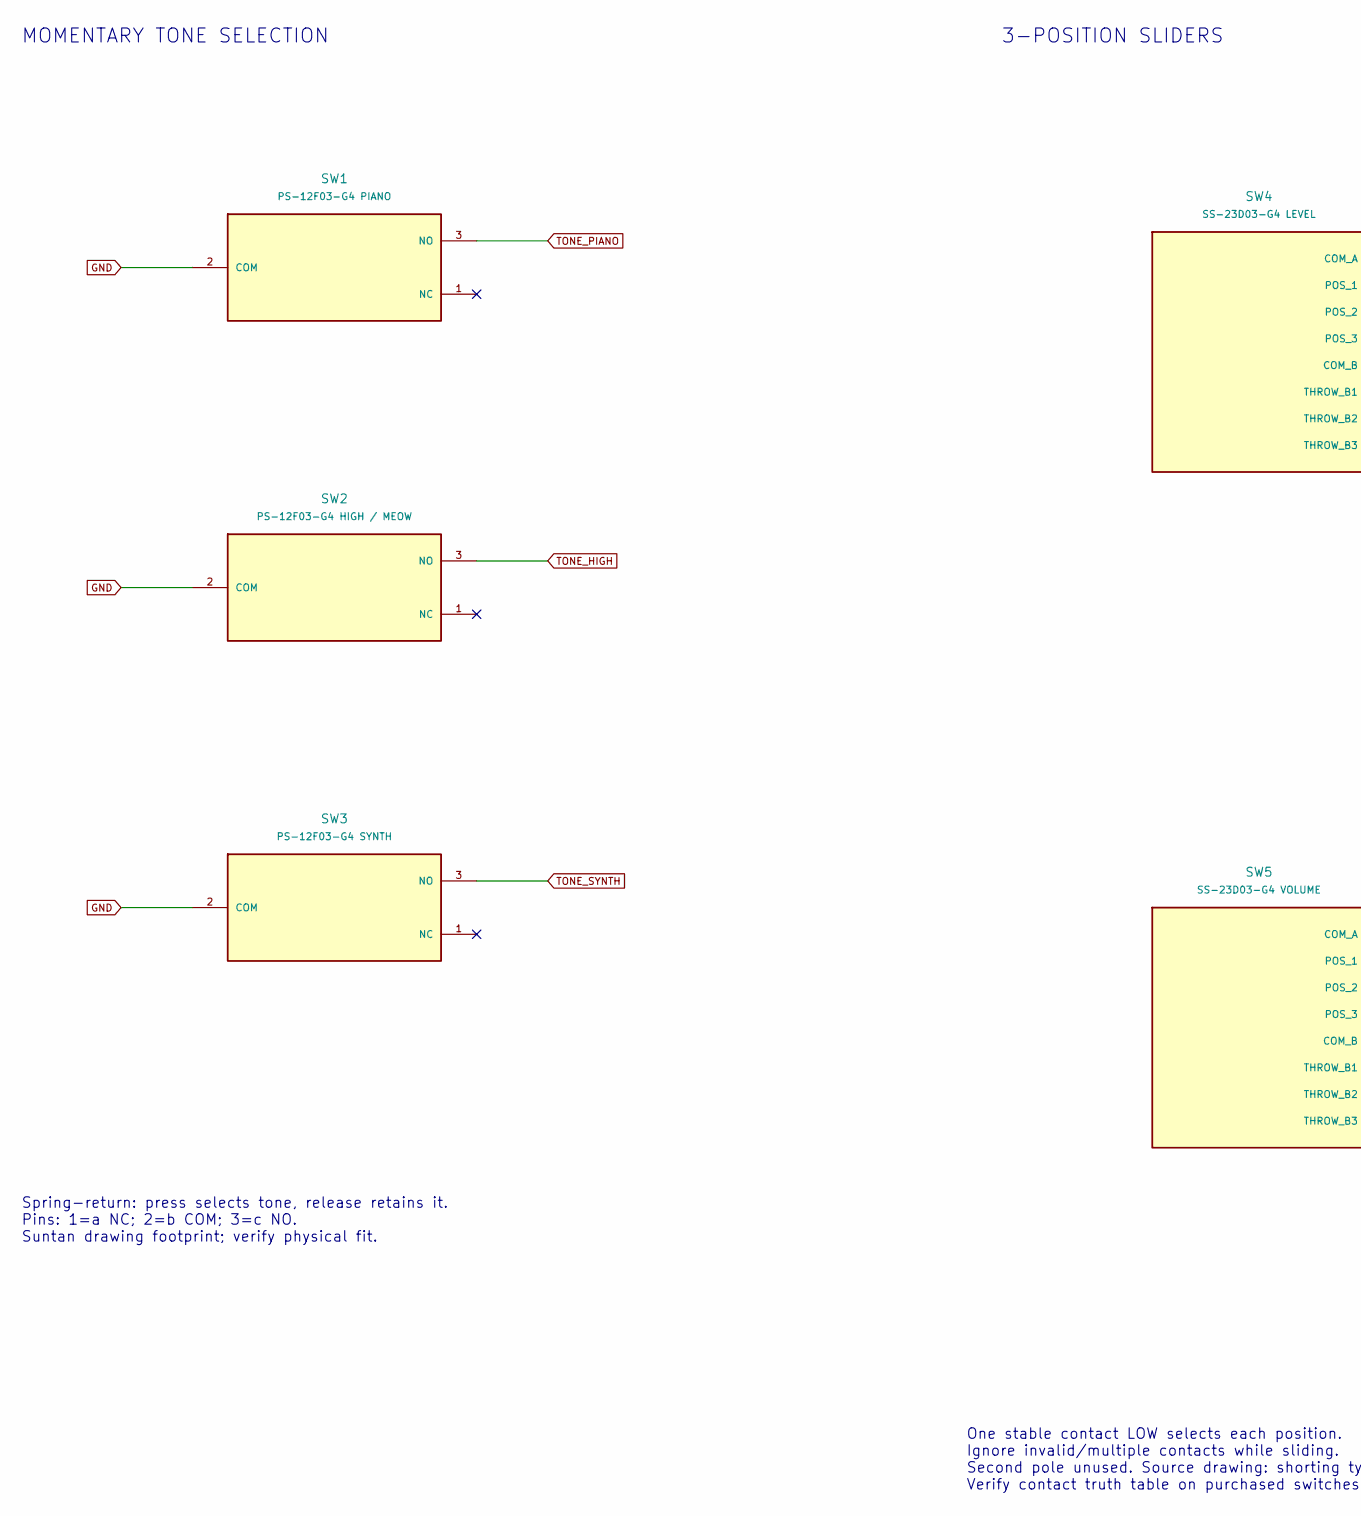
[picture p13: schematic Selectors.kicad_sch, Tone buttons, level and volume, part in row 1, column 1]

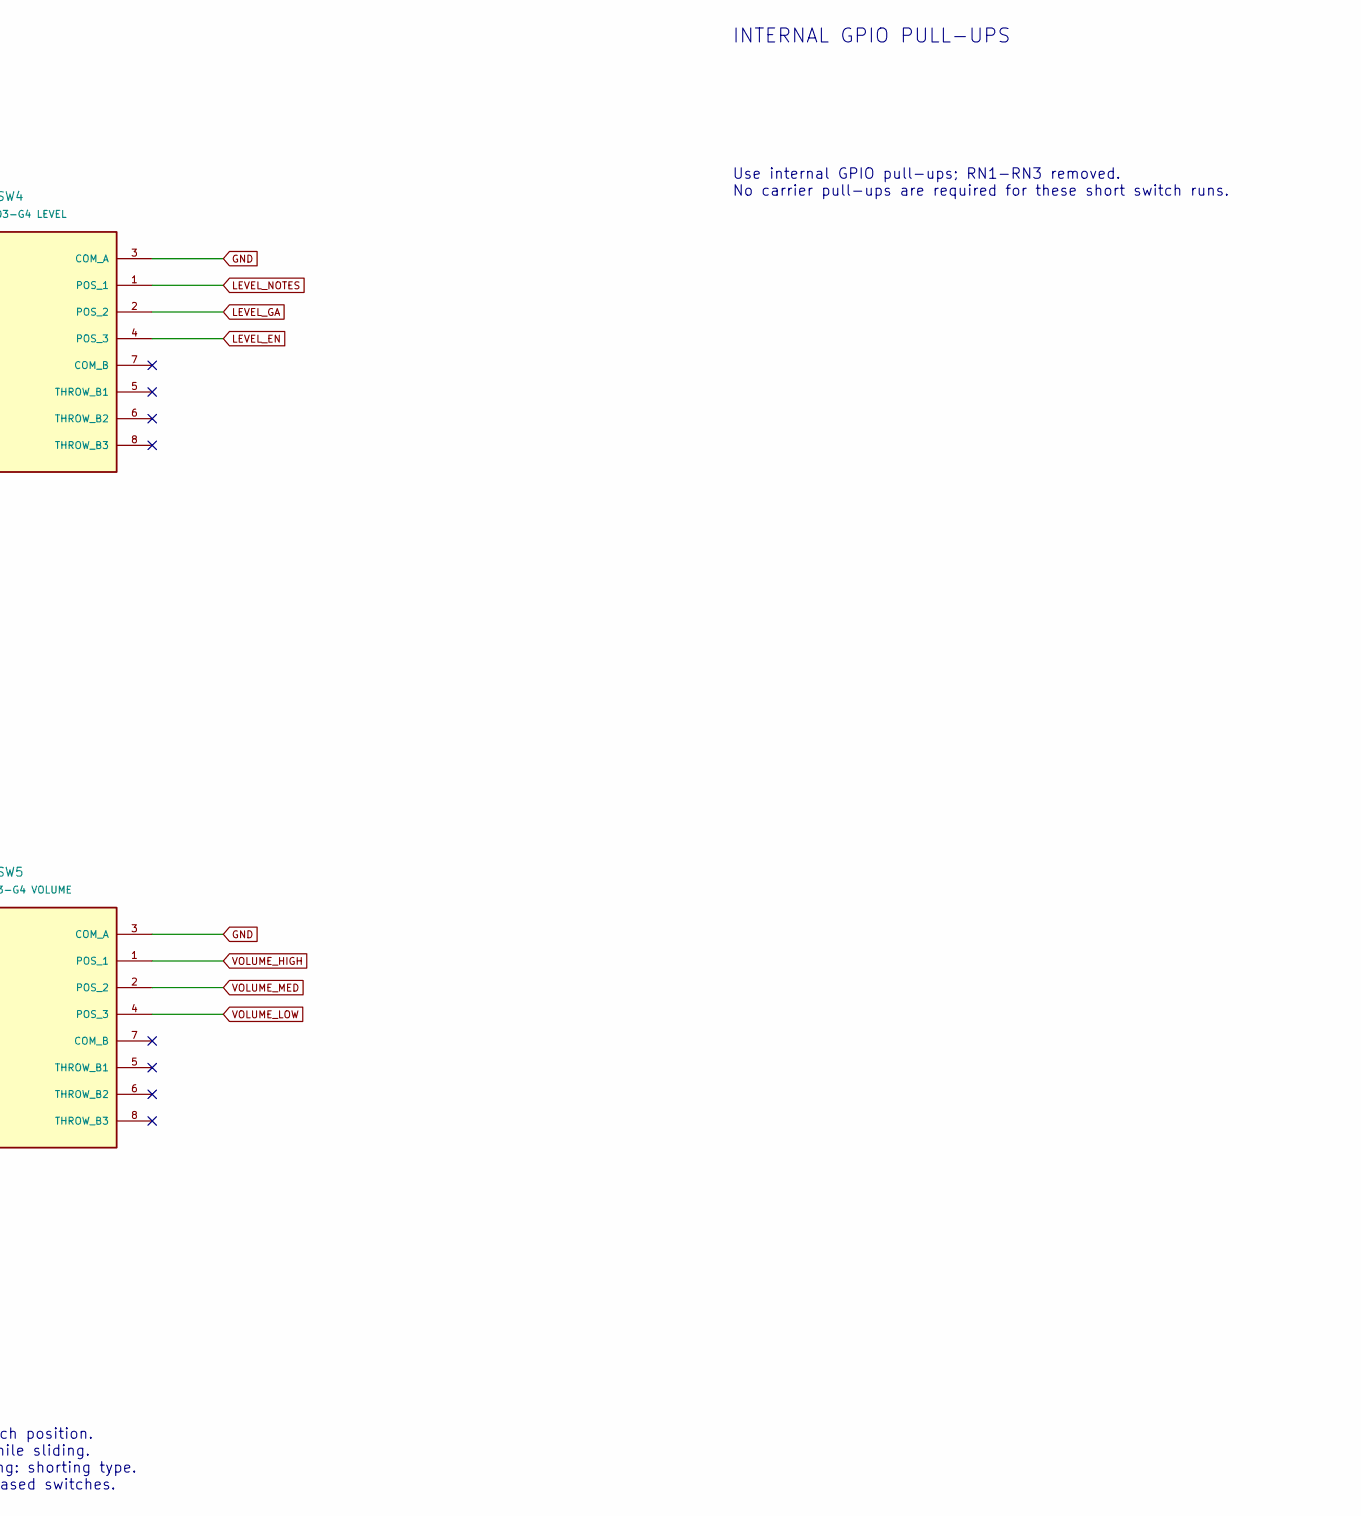
[picture p14: schematic Selectors.kicad_sch, Tone buttons, level and volume, part in row 1, column 2]

Parts:
SW1: PS-12F03-G4 PIANO; PS12F03_Momentary_3Pin_P3.2
SW2: PS-12F03-G4 HIGH / MEOW; PS12F03_Momentary_3Pin_P3.2
SW3: PS-12F03-G4 SYNTH; PS12F03_Momentary_3Pin_P3.2
SW4: SS-23D03-G4 LEVEL; SS23D03_G4_2P3T_P2_P4
SW5: SS-23D03-G4 VOLUME; SS23D03_G4_2P3T_P2_P4

Connections:
GND: SW1.2 (COM), SW2.2 (COM), SW3.2 (COM), SW4.3 (COM_A), SW5.3 (COM_A); also elsewhere on the board
LEVEL_EN: SW4.4 (POS_3); also elsewhere on the board
LEVEL_GA: SW4.2 (POS_2); also elsewhere on the board
LEVEL_NOTES: SW4.1 (POS_1); also elsewhere on the board
TONE_HIGH: SW2.3 (NO); also elsewhere on the board
TONE_PIANO: SW1.3 (NO); also elsewhere on the board
TONE_SYNTH: SW3.3 (NO); also elsewhere on the board
VOLUME_HIGH: SW5.1 (POS_1); also elsewhere on the board
VOLUME_LOW: SW5.4 (POS_3); also elsewhere on the board
VOLUME_MED: SW5.2 (POS_2); also elsewhere on the board

Notes on the sheet:
Spring-return: press selects tone, release retains it. Pins: 1=a NC; 2=b COM; 3=c NO. Suntan drawing footprint; verify physical fit.
MOMENTARY TONE SELECTION
3-POSITION SLIDERS
INTERNAL GPIO PULL-UPS
One stable contact LOW selects each position. Ignore invalid/multiple contacts while sliding. Second pole unused. Source drawing: shorting type. Verify contact truth table on purchased switches.
Use internal GPIO pull-ups; RN1-RN3 removed. No carrier pull-ups are required for these short switch runs.

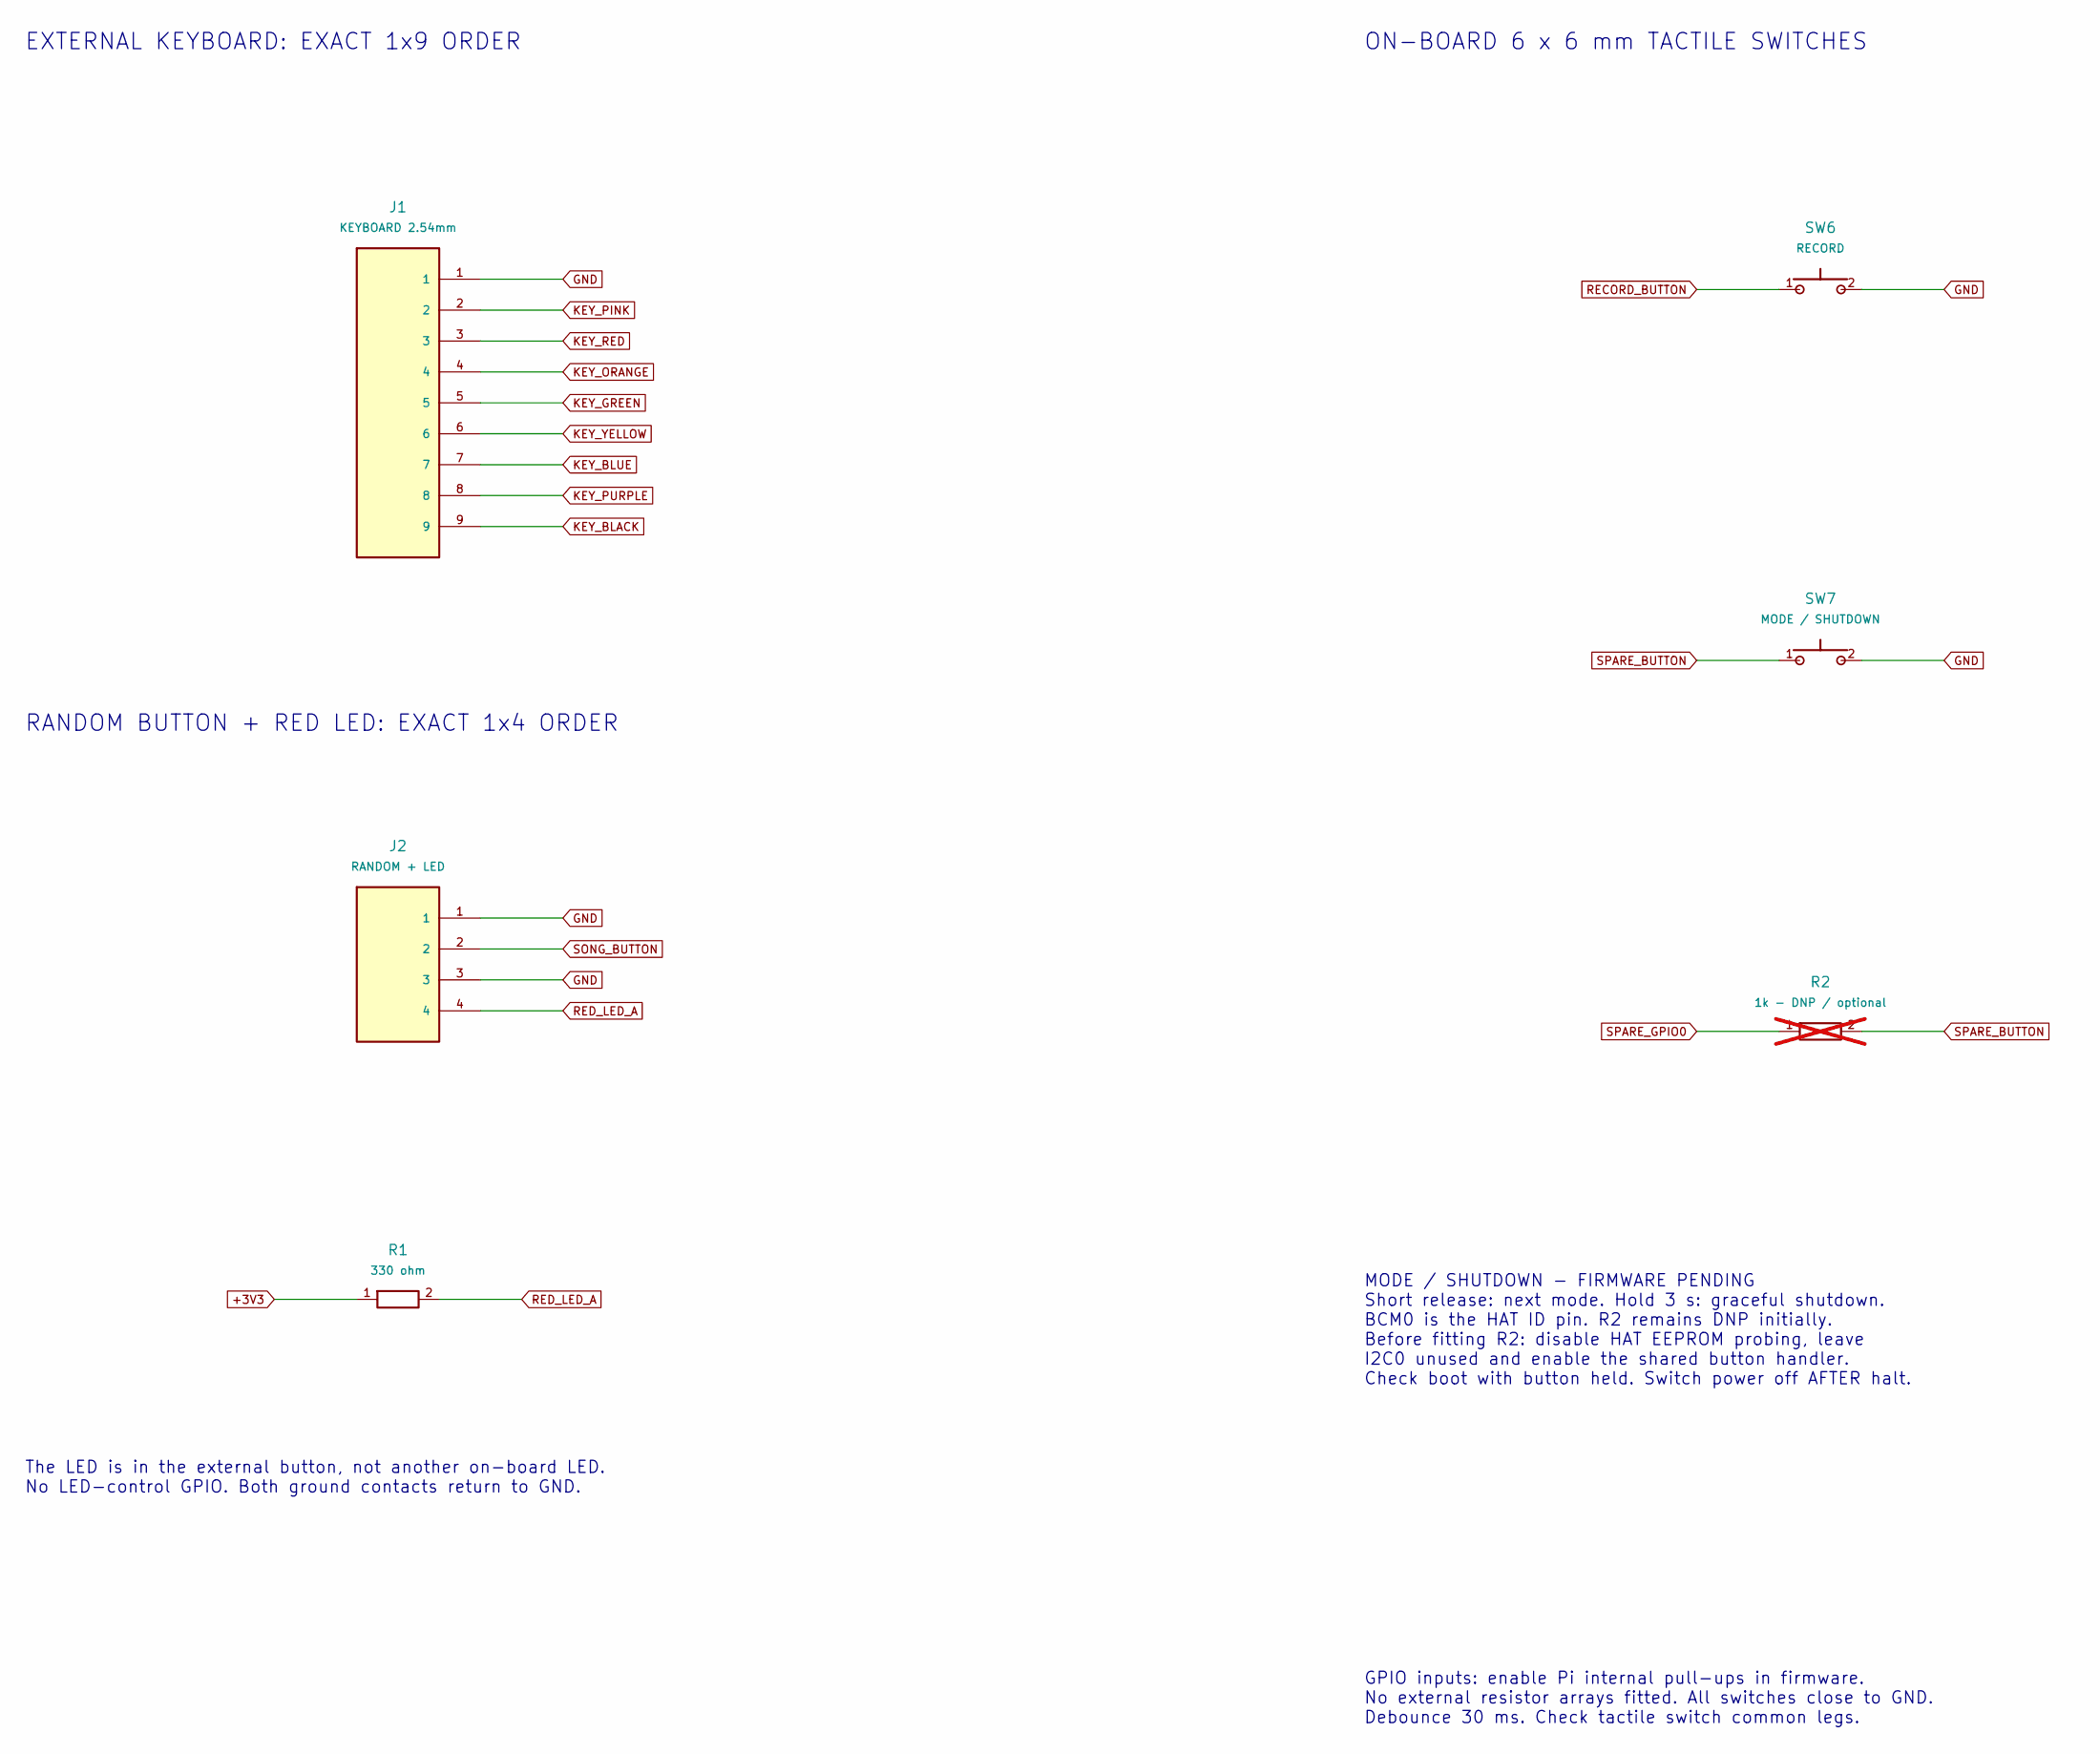
[picture p15: schematic Controls.kicad_sch, Keyboard, buttons and Random LED]

Parts:
J1: KEYBOARD 2.54mm; PinHeader_1x09_P2.54mm_Vertical
J2: RANDOM + LED; PinHeader_1x04_P2.54mm_Vertical
R1: 330 ohm; R_1206_3216Metric_Pad1.30x1.75mm_HandSolder
R2: 1k - DNP / optional; R_1206_3216Metric_Pad1.30x1.75mm_HandSolder; not fitted
SW6: RECORD; SW_PUSH_6mm
SW7: MODE / SHUTDOWN; SW_PUSH_6mm

Connections:
+3V3: R1.1; also elsewhere on the board
GND: J1.1, J2.1, J2.3, SW6.2, SW7.2; also elsewhere on the board
KEY_BLACK: J1.9; also elsewhere on the board
KEY_BLUE: J1.7; also elsewhere on the board
KEY_GREEN: J1.5; also elsewhere on the board
KEY_ORANGE: J1.4; also elsewhere on the board
KEY_PINK: J1.2; also elsewhere on the board
KEY_PURPLE: J1.8; also elsewhere on the board
KEY_RED: J1.3; also elsewhere on the board
KEY_YELLOW: J1.6; also elsewhere on the board
RECORD_BUTTON: SW6.1; also elsewhere on the board
RED_LED_A: J2.4, R1.2
SONG_BUTTON: J2.2; also elsewhere on the board
SPARE_BUTTON: R2.2, SW7.1
SPARE_GPIO0: R2.1; also elsewhere on the board

Notes on the sheet:
GPIO inputs: enable Pi internal pull-ups in firmware. No external resistor arrays fitted. All switches close to GND. Debounce 30 ms. Check tactile switch common legs.
EXTERNAL KEYBOARD: EXACT 1x9 ORDER
MODE / SHUTDOWN - FIRMWARE PENDING Short release: next mode. Hold 3 s: graceful shutdown. BCM0 is the HAT ID pin. R2 remains DNP initially. Before fitting R2: disable HAT EEPROM probing, leave I2C0 unused and enable the shared button handler. Check boot with button held. Switch power off AFTER halt.
ON-BOARD 6 x 6 mm TACTILE SWITCHES
RANDOM BUTTON + RED LED: EXACT 1x4 ORDER
The LED is in the external button, not another on-board LED. No LED-control GPIO. Both ground contacts return to GND.

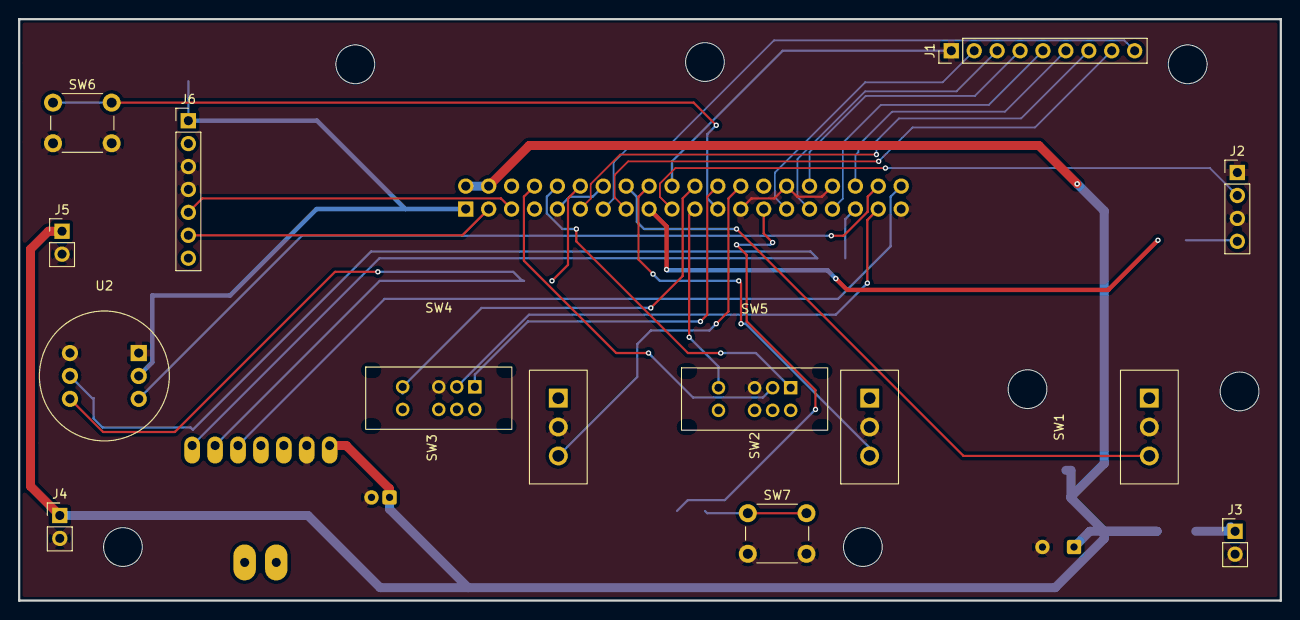
[picture p16: board DJTable.kicad_pcb from above]

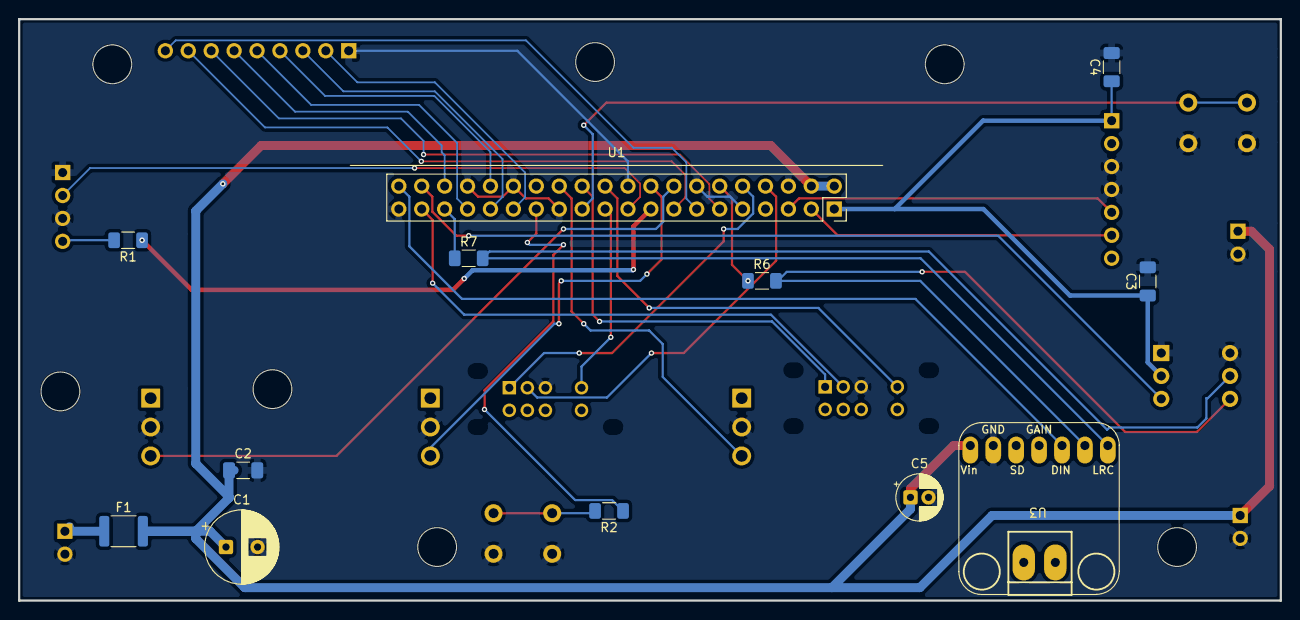
[picture p17: board DJTable.kicad_pcb from below]

Board: 2 copper layers, 139.8 x 64.4 mm, 26 parts (12 on the bottom side), 34 nets.

Other parts of the board:
C3: 100nF; C_1206_3216Metric_Pad1.33x1.80mm_HandSolder

Their connections:
+3V3: C3.1; also elsewhere on the board
GND: C3.2; also elsewhere on the board
