LifeOnAFarm/RaveLearnDJTable/(commit log)

2026-10-09 First public release
    Raspberry Pi Zero 2 W rebuild of a kids' DJ table toy: Learning, Music
    Maker and Bluetooth modes, web pages, setup scripts, docs and tests.
2026-10-10 Pare down to overview, install and sound guides; one-step installer
    The repo now covers what the table is, what it does, how to install it and
    how to replace its sounds. The hardware guide lives on the project website.
    - deploy/install.sh installs everything in one step: packages, Python,
    starter sounds, services, the PCB speaker/microphone overlay and pins,
    and Bluetooth mode.
    - The defaults match the finished table: INMP441 microphone and platter on,
    full volume.
    - deploy/tune-pi.sh (optional, recommended) also moves Imager's Wi-Fi to
    NetworkManager's own format.
    - Removed the hardware, Music Maker and voice instrument guides, the drum
    example, the media checker and the bench to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
    [__main__.py]
2026-10-10 Starter sounds: skip existing previews; preview one-shot samples directly
    Building a preview for a one-shot instrument (no sustain loop, as in the
    House sample pack) divided by a zero-length loop and stopped the installer.
2026-10-10 Original House keyboard sounds and platter scratches
    House now has its own synthesised sounds in F minor, laid out like the
    finished table's: a different chord on every key (sustained), a short
    minor-seventh stab (one-shot) and a deep bass (sustained), loudness-matched
    to the other themes. The three platter scratches are original recordings;
    the installer copies them into assets/scratch without replacing your own.
    [instruments.py]
2026-10-10 Include words, announcements and the recording prompt
    - Colour and shape words in English and Irish (Microsoft Emily and Orla
    voices), levelled to match the table.
    - New spoken announcements for theme, mode and Level changes, Bluetooth
    connection and Music Maker clears, and a new recording prompt with the
    882 Hz beep the capture filter expects.
    - The installer copies everything in sounds/ into assets/ before generating
    the rest, and never replaces a file that is already there.
2026-10-10 Add the PCB: Gerbers, schematic, KiCad project and parts list
    hardware/README.md lists the parts and the hand-wired fixes this board
    revision needs: amp SD to Pi header pin 7, amp GAIN to ground, the Pi
    mounted upside-down, and SS-23D03-G4 / PS-12F03-G4 switches in place of
    the toy's originals.
    [Audio_Sensor.kicad_sch, Controls.kicad_sch, DJTable.kicad_pcb, DJTable.kicad_sch, Selectors.kicad_sch]
2026-10-10 Hardware notes: bridge R2, drop the pin 38/40 check
    R2 is bridged with 0 ohm on the built board. The PS-12F03-G4 legs fit as
    they are, and the pin 38/40 bridge note did not apply.
2026-10-10 Add 3D printed parts: platter mount, AS5600 mount, Mode button, speaker holder
    [AS5600 Mount.STL, Mode Button.STL, Platter Mount.STL, Speaker Holder.STL]
2026-10-10 Admin: live pin table for troubleshooting
    Lists every input with its GPIO and header pin, whether it is grounded now
    and when it was last grounded (so quick taps show too). Slider notes name
    the contacts when more than one is touching.
2026-10-10 Physical switches win after a restart
    A Tone/Level/Volume setting made on the Admin page was reapplied at every
    start, so a saved test setting overrode the switches until they moved.
2026-10-10 Hardware: PS-12F03-G5 for the Tone buttons
2026-10-10 Call the song button the NumPad; measured install time
    The toy's song button looks like a number pad, so the docs and Admin page
    now call it the NumPad. Generating the sounds on a Zero 2 W takes about
    2 minutes (measured), so the install takes about 5-10 minutes, not 10-20.
2026-10-11 Fix a rare audio crash at the end of a sound played off-speed
    When the platter changed playback speed (Music Maker loops), rounding could
    put the last read position exactly at the end of a sound and stop the audio
    callback. The read position is now held on the last sample.
    [core.py]
2026-10-12 Hardware: printable switch covers for the taller SS-23D03-G4
    The SS-23D03-G4 stands about 2 mm taller than the toy's switches: print the
    new switch covers or cut about 2 mm off the originals. Notes that a future
    board should use a switch with a body about 5.5 mm tall instead of 7.5 mm.
    [Switch Cover.STL]
2026-10-12 Shutdown: hold Mode and Record together for 10 seconds
    The table plays the shutting-down announcement, then writes
    /run/djtable/shutdown; a root path unit (djtable-shutdown.path) powers the Pi
    off. While both buttons are involved, neither changes theme or keyboard mode
    or starts a recording.
